rambo/dmdt-865_expansion/android/T865PortProbe/analysis/pins9-11-lora-cycle-2026-11-07/README.md

# pins9-11-lora-cycle-2026-11-07 capture notes

See [PINS9-11-LORA-CYCLE-2026-11-07.md](../PINS9-11-LORA-CYCLE-2026-11-07.md) for setup, results and limitations.
run_cycle.py performs a real DMD LoRa UI cycle; it is not a dry-run test.
Mapping CH1->10 CH2->9 CH3->3 CH4->11, ground pin 1. CH3 contact unverified.
