rambo/dmdt-865_expansion/references/fcc/SOURCES.md

# FCC photo sources retrieved 2026-11-06

Unmodified manufacturer/lab-submitted FCC exhibits obtained through FCCID.io.
None is established as a teardown of the Topicon MOD-LORA-E220 assembly.
EByte: one page, bare 433 MHz E220-400T30S radio; not the advertised 850-930 MHz Topicon accessory.
MDT865: seven pages total, tablet boards; no identifiable complete MOD-LORA-E220 assembly found in these reviewed pages.
The original FCC download endpoint returned HTTP 403; mirror PDFs were rendered and visually reviewed.
The EByte mirror is 649523 bytes (its metadata page lists 649525); the hash below describes the actual retrieved file.

EByte-E220-400T30S-internal-4983216.pdf
https://fccid.io/2ALPHE220/Internal-Photos/Internal-Photos-4983216.pdf
SHA256 43314c6d11cfb36a85e58e730b1f34d73f2a3e027f5b84f49c595dc417bbab7f

Topicon-MDT865-internal-01-6401292.pdf
https://fccid.io/2AHAFMDT865/Internal-Photos/Internal-Photos-01-6401292.pdf
SHA256 05f91a671e476278785c18257021d6a596d394e336b628edc07daaa0d4611135

Topicon-MDT865-internal-02-6401295.pdf
https://fccid.io/2AHAFMDT865/Internal-Photos/Internal-Photos-02-6401295.pdf
SHA256 d5247d95b9333e15b3ec4a690ce241914ec09cd2e26f199c34677c270b64be69
