rambo/dmdt-865_expansion/android/T865PortProbe/analysis/EXPANSION-PIN-BASELINE-2026-11-07.md

# Expansion contact baseline - 2026-11-07, Europe/Helsinki

## USER NUMBERING: VIEWED FROM TABLET BACKSIDE

Pin numbers run left-to-right within each row, then top-to-bottom.
Top-left pin 1; top-right pin 2; bottom-left pin 11; bottom-right pin 12.
These are local investigation labels, not established OEM numbering.

| Row | Left | Right |
| --- | --- | --- |
| Top | 1 GND? | 2 CH3 |
| 2 | 3 CH2 | 4 CH1 |
| 3 | 5 CH4 | 6 unknown |
| 4 | 7 +3.3 V? | 8 unknown |
| 5 | 9 unknown | 10 unknown |
| Bottom | 11 unknown | 12 unknown |

## USER CLARIFICATION AFTER CAPTURE

Ground clips were connected to pin 1. The user measured pin 7 near 3.3 V
relative to pin 1 and to known cradle-connector power pads: two ground pads
and two 5 V pads. This corroborates pin 1 as the ground reference; readings are
user-reported, not an independent scope measurement of pin 7.
The user removed probes to enable USB debugging. Timing relative to the scope
queries/screen capture is uncertain. Therefore the channel readings below are
NOT A VALID CONNECTED-PIN BASELINE and cannot establish any pad's voltage or role.
The mapping above records intended wiring. Actual probe multiplier switches
remain unconfirmed; the scope configuration alone reports x10.

## SCOPE CONNECTION

RIGOL TECHNOLOGIES,DS1074Z,DS1ZA162953663,00.04.05.SP2

Address 192.168.220.72, raw SCPI TCP port 5555 (5025 refused).
VXI-11/RPC port 111 and HTTP port 80 were reachable; raw SCPI was used.
HTTP welcome page has inconsistent placeholder instrument fields; trust *IDN?
and the LXI identification endpoint rather than that HTML model/serial.
Acquisition was running AUTO; no trigger, acquisition, display or channel settings
were changed. Query-only measurement readout and a screen PNG were collected.
Time scale: 5 ms/div; sampling readout: 50 MSa/s; all channels enabled, DC
coupling, 1 V/div, scope probe multiplier x10, no inversion or bandwidth limit.

## SCOPE CHANNEL READOUT ONLY - PROBE CONNECTIONS NOT VERIFIED AT CAPTURE

Sequential live queries, not a simultaneous capture. Planned pin column records
intended wiring only; do not attribute these values to the physical pins.

| Pin | Channel | Average mV | Peak-to-peak mV |
| --- | --- | --- | --- |
| 2 | CH3 | -19.97 | 80.0 |
| 3 | CH2 | -25.22 | 120.0 |
| 4 | CH1 | 4.41 | 160.0 |
| 5 | CH4 | -34.62 | 240.0 |

All frequency queries returned the scope invalid/unavailable sentinel 9.9E37;
CH1 minimum-voltage query also returned that sentinel. These are not voltages
or valid frequency values. The screen snapshot shows small common ripple rather
than obvious full-amplitude logic transitions. This baseline does not distinguish
ground, low outputs, disabled buses, unpowered interfaces, or floating inputs.
It does not exclude intermittent UART/I2C/SPI activity outside the snapshot.

## ADB BASELINE

ADB initially had no USB device; tablet subsequently appeared with transport_id 4.
T865 / mdt865, firmware mdt865_14_ngms_2.8.6, SELinux Enforcing, shell UID 2000.
DMD2 launcher and port probe v1.1 were present as running processes. No dmdLora
or freeme.factory process was shown by the targeted process query.
/dev/expand remains 0666 gpio_ctrl_device; WK1-3 remain 0666 user_tty_device.
No Activity was started and no screen interaction or settings changes were made.

## STATUS / NEXT STEP

User intends to install an available system update before continuing. Hardware
probing is paused at the user's request. The assistant did not initiate an update.
After the user resumes, re-read firmware fingerprint/kernel/config/permissions;
the recorded mdt865_14_ngms_2.8.6 and kernel investigation describe pre-update
software. Confirm probes are reconnected with the intended mapping and physical
attenuation settings, then capture a fresh baseline before any active experiment.
No expansion-device open, ioctl, EEPROM action, serial configuration, UART write,
power toggle, reboot or app installation was performed for this baseline.

## EVIDENCE

analysis/scope-2026-11-07/baseline-2026-11-07.json (timestamped SCPI queries)
analysis/scope-2026-11-07/baseline-2026-11-07.png (scope screen)
analysis/scope-2026-11-07/screen-query.json (screen-query provenance)
analysis/scope-2026-11-07/adb-baseline-2026-11-07.txt (tablet metadata)

SCPI command reference: RIGOL DS1000Z Programming Guide, :MEASure:ITEM?.
https://www.rigol.com/intl/products/oscilloscope/DS1000Z.html
