rambo/dmdt-865_expansion/android/T865PortProbe/analysis/REMAPPED-LORA-CYCLE-2026-11-07.md

# T865 remapped LoRa cycle — 2026-11-07 11:47 EET (09:47 UTC)

## RESULT

One requested enable cycle completed; original LoRa OFF, display keep-awake=0,
and original scope setup were restored and verified. The service is stopped.
Pin 7 stayed approximately 3.3 V. No full logic-level UART-like transitions were
captured on these channels. The earlier pin-3 pulse did NOT appear on new CH3.
The user subsequently reports CH3 may have become misaligned. Treat this cycle's
CH3/pin-3 result as unreliable for pad behavior; it does not overturn the earlier
708 ms pulse measured with CH2. Check CH3 tip/contact/location before another
experiment. No additional enable cycle was run after this capture.

## SETUP

Ground: pin 1. Backside rowwise numbering: (1,2),(3,4),(5,6),(7,8),(9,10),(11,12).
CH1 -> pin 6; CH2 -> pin 7; CH3 -> pin 3; CH4 -> pin 8.
All scope channels DC, 1 V/div, scope probe factor 10x. Physical probe switches
and tip contacts were not independently verified. Rigol DS1074Z, SCPI TCP 5555
at 192.168.220.72. Current firmware: mdt865_16_ngms_1.2.7, kernel 6.6.102.
The user's fluctuating measurement was pin 7 referenced to pin 8, never pin 3.
Pin 7 reads around 3.3 V referenced to pin 1. Pin 8 is NOT confirmed ground.

## CAPTURE VALIDITY

Scope armed in SINGLE, waited for WAIT, then FORCE accepted with TD readback
before the ADB enable tap. 3,000,000 BYTE samples/channel, 4 us/sample, covering
-1.2 to +10.799996 s relative to trigger. Trigger TD confirmed at 09:47:11.475 UTC;
enable tap began at 09:47:11.477, completed at 09:47:11.605. Scope STOP confirmed
at 09:47:22.442. The automatic ~0.7 s initialization attempt is inside the record.
Original and restored switch XML read OFF; enabled UI read ON, but the view can
lag the service's automatic preference update. Scope screenshot, raw waveforms,
preambles, command transcripts and host UTC events are preserved alongside this
report. Host and device wall clocks were not independently synchronized.

## MEASURED VOLTAGES (from raw samples and each channel's own preamble)

| Channel / stated pad | Minimum V | Median V | Maximum V |
| --- | --- | --- | --- |
| CH1 / pin 6 | 0.144 | 0.240 | 0.336 |
| CH2 / pin 7 | 3.150 | 3.294 | 3.437 |
| CH3 / pin 3 | 0.000 | 0.000 | 0.000 CONTACT SUSPECT |
| CH4 / pin 8 | -0.144 | -0.048 | 0.048 |

BYTE quantization is about 48 mV/count; these are approximate voltage readings,
not precision rail measurements. CH3 data is one constant ADC code throughout.
Small offsets/noise do not establish a pin's function or prove a ground.
No captured channel spans even 0.3 V; no normal 3.3 V UART pattern is visible.
This does not locate TX/RX or exclude traffic on other pins, or missed contact.

## DEVICE LOG INTERPRETATION

The DMD service again successfully opens /dev/expand. Native setPower(2,true)
and writeIo(2,1,true) return 0. Driver reports right-position user=1 and GPIO566
set to 1 SUCCESS. WK2 opens at 9600/8N1, then SleepConfig fails after ~0.5 s,
consistent with no compatible module attached. The driver reports GPIO release
and power-off; on/off log timestamps differ by approximately 692 ms.
These logs confirm software requests and return values; they do NOT verify the
voltage at a specific pad. Logical position 2 and GPIO566 are not physical pad IDs.

This attempt also reached DMD's fifth consecutive initialization failure with
no previous success. It logged 'Persistent disable' and set lora_enabled=false.
Static LoraService code confirms this threshold changes that saved preference;
it is not evidence of a new firmware block or irreversible device lockout.
Failure counters/preferences were not cleared. LoRa was originally OFF and ends
OFF. No radio module is attached; this session does not establish radio behavior.

## EVIDENCE / NEXT STEP

See remapped-lora-cycle-2026-11-07/ (SHA256SUMS.txt validates saved artifacts).
Earlier valid pulse: [POST-UPDATE-INVESTIGATION-2026-11-07.md](POST-UPDATE-INVESTIGATION-2026-11-07.md) and
post-update-2026-11-07/successful-cycle/. Its mapping was CH2 -> pin 3.
Do not confuse it with new CH2 -> pin 7. Retain that earlier pulse as stronger
pin-3 evidence pending probe-contact verification. Pin 7's constant voltage is
consistent with an always-present supply but does not identify the regulator or
prove its role. Pin 8's function and the UART contacts remain unconfirmed.
