rambo/dmdt-865_expansion/cad/fit-check/four-plates-preview.png

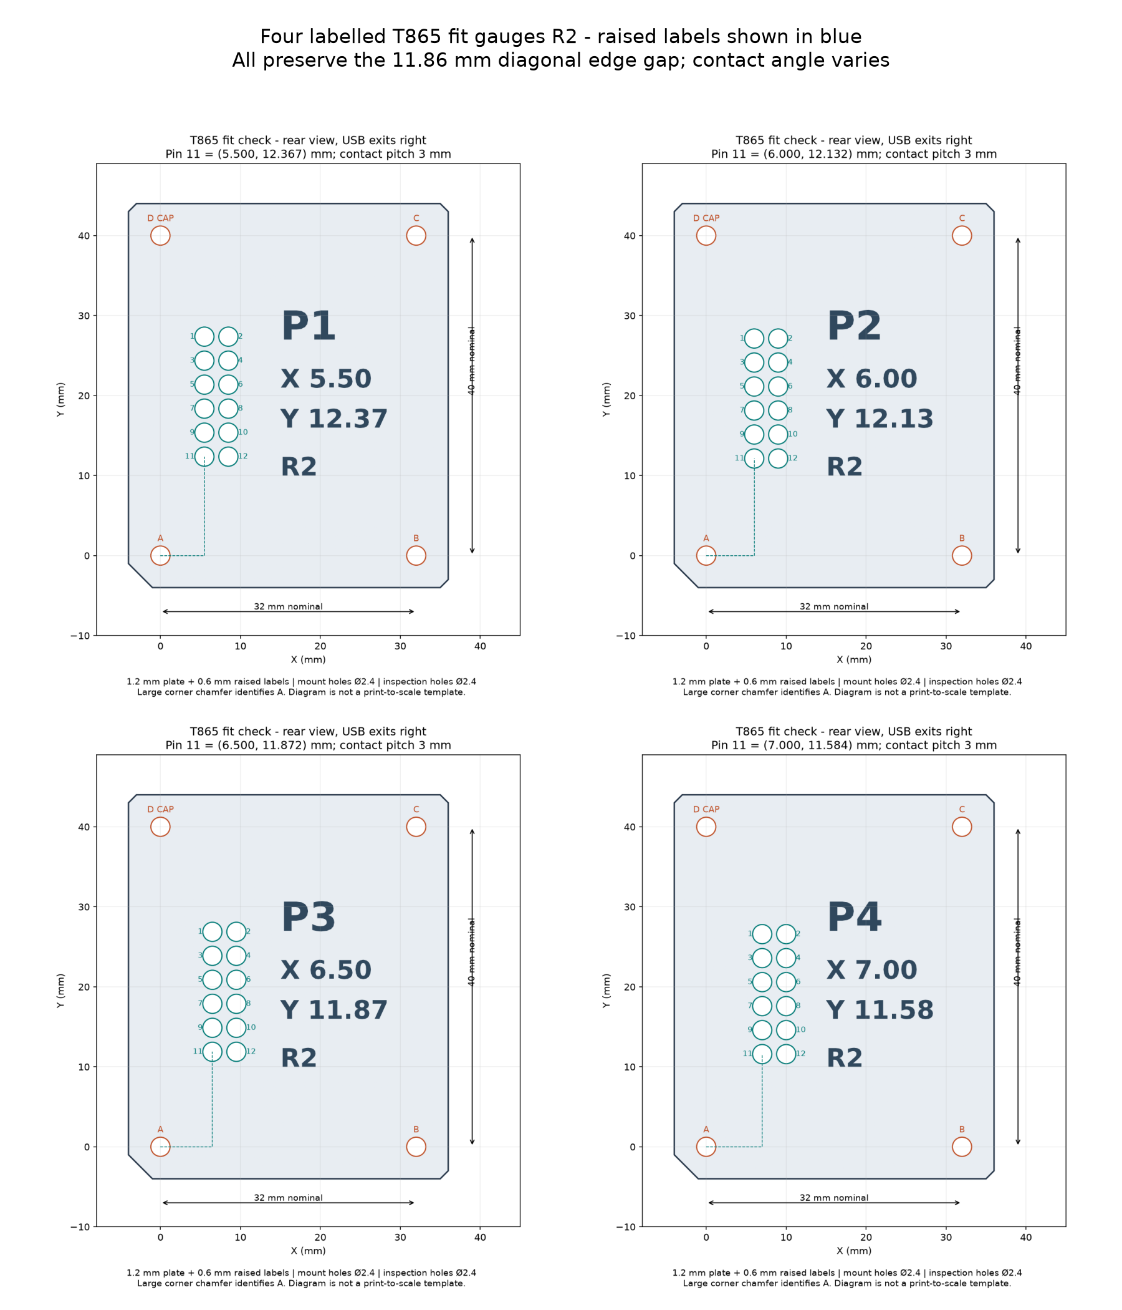
cad/fit-check/four-plates-preview.png
