rambo/dmdt-865_expansion/cad/fit-check/layout-P1.png

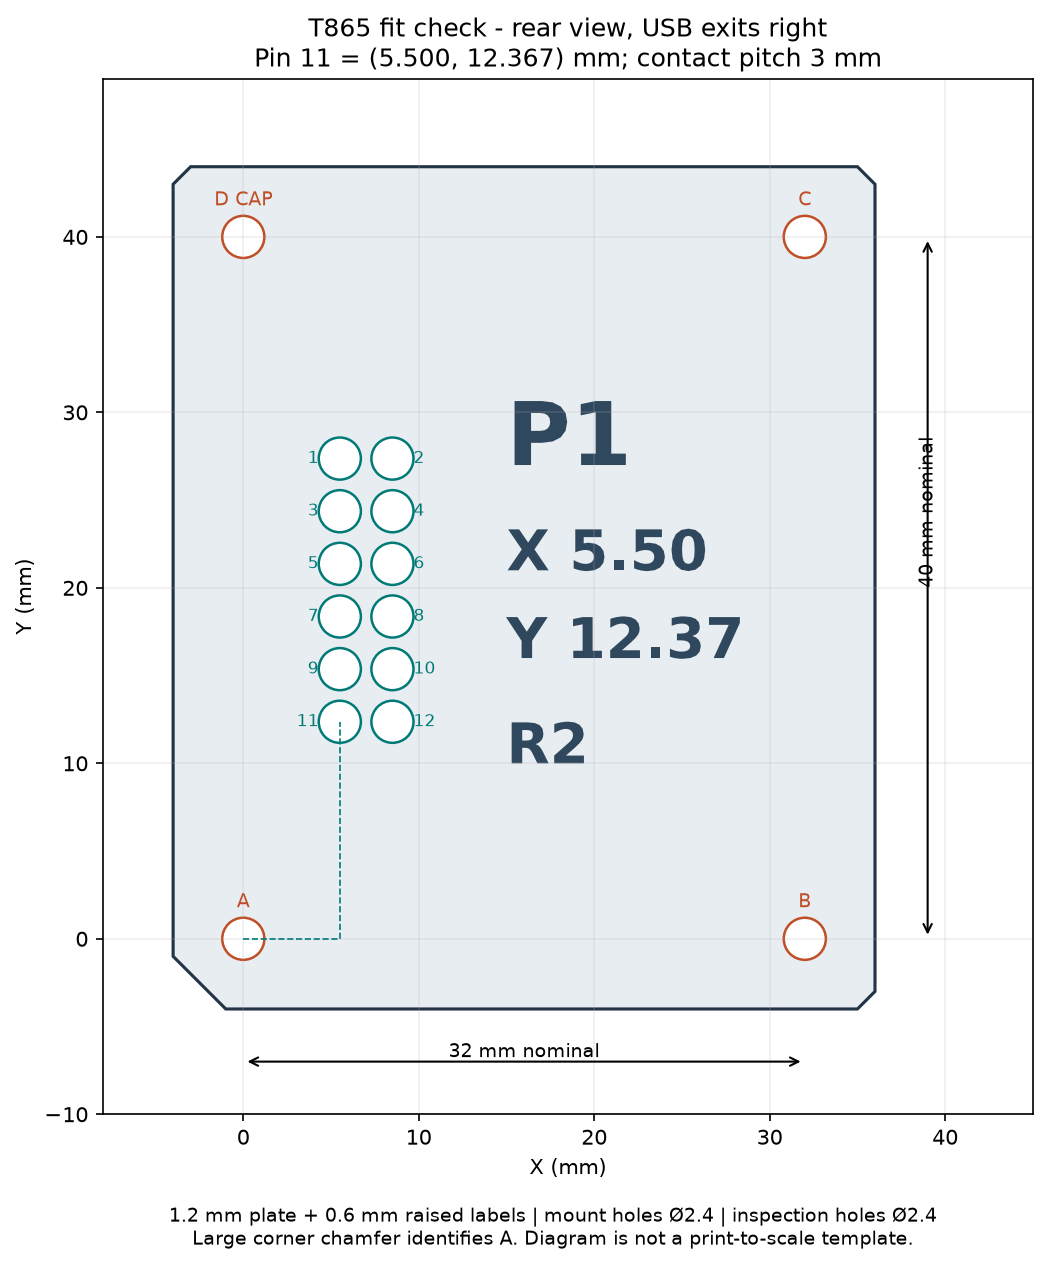
cad/fit-check/layout-P1.png
