rambo/dmdt-865_expansion/references/fcc/inspection/ebyte-photos-alt-overview.png

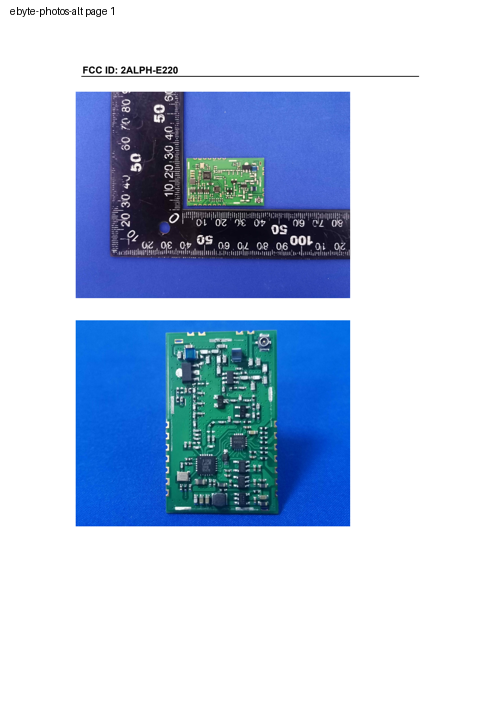
references/fcc/inspection/ebyte-photos-alt-overview.png
