rambo/dmdt-865_expansion/references/fcc/inspection/ebyte-photos-alt-p1-image0-Im1.jpg

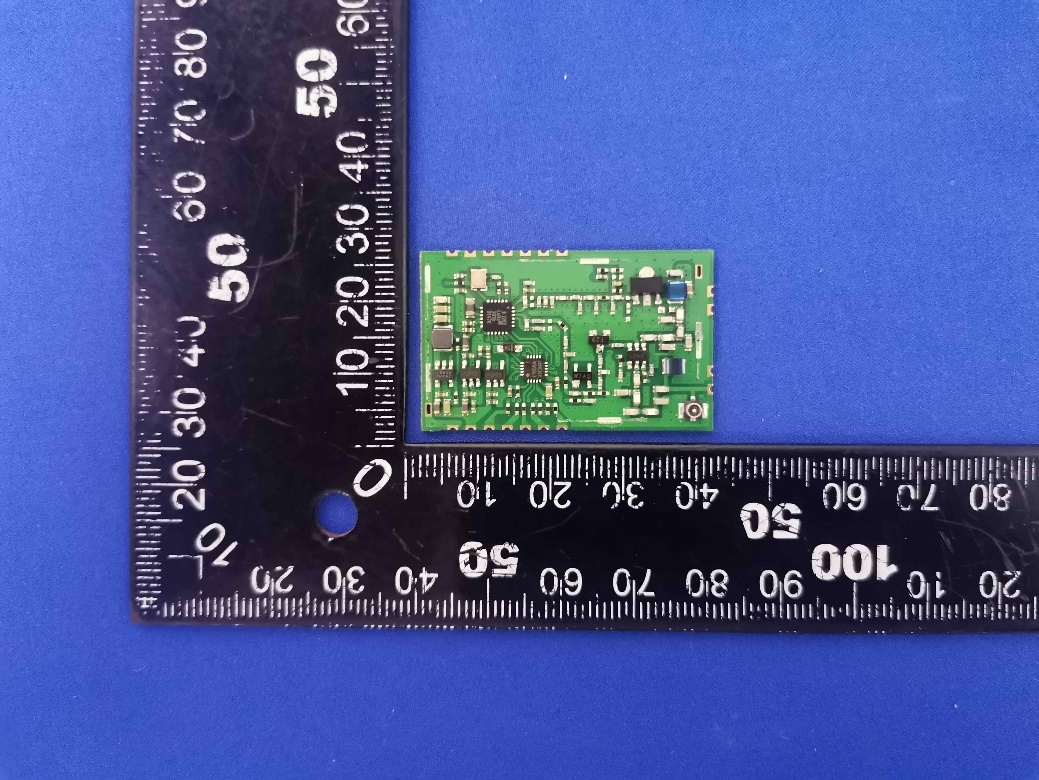
references/fcc/inspection/ebyte-photos-alt-p1-image0-Im1.jpg
