rambo/dmdt-865_expansion/references/fcc/inspection/ebyte-photos-alt-p1-image1-Im2.jpg

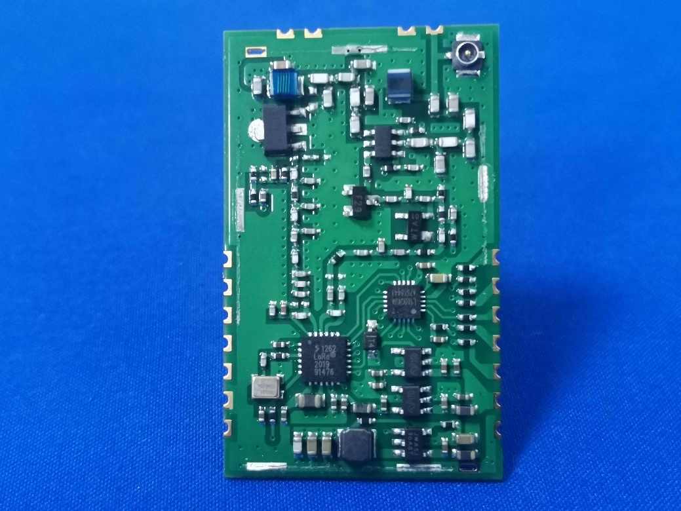
references/fcc/inspection/ebyte-photos-alt-p1-image1-Im2.jpg
