rambo/dmdt-865_expansion/references/fcc/inspection/mdt865-internal01-p4-image0-IM65.jpg

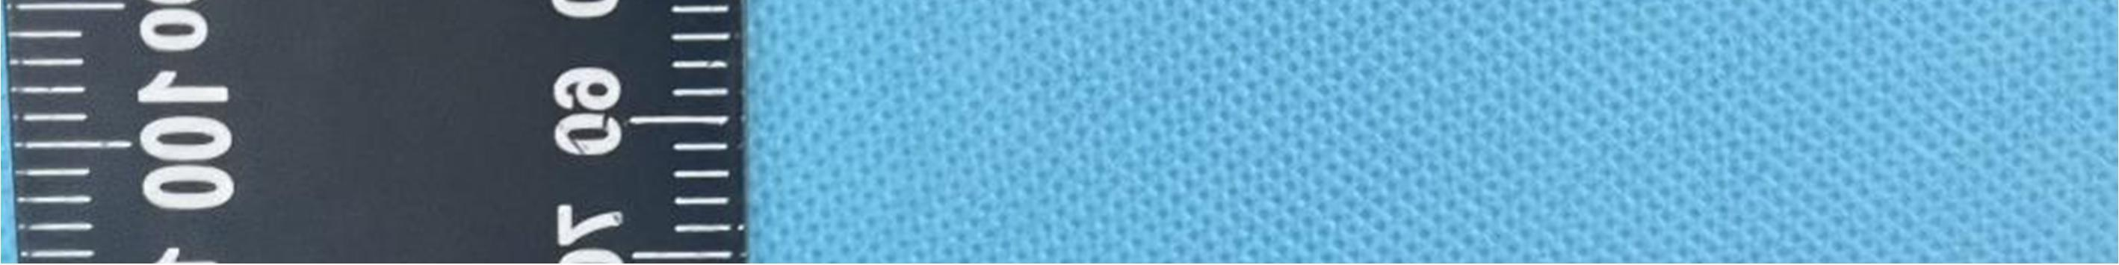
references/fcc/inspection/mdt865-internal01-p4-image0-IM65.jpg
