rambo/dmdt-865_expansion/references/fcc/inspection/mdt865-internal01-p4-image2-IM67.jpg

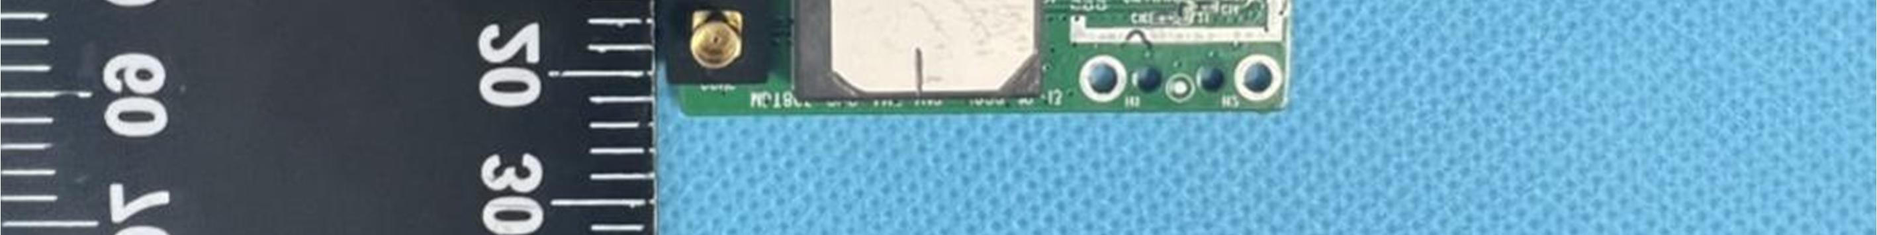
references/fcc/inspection/mdt865-internal01-p4-image2-IM67.jpg
