rambo/dmdt-865_expansion/references/fcc/inspection/mdt865-internal01-page5.png

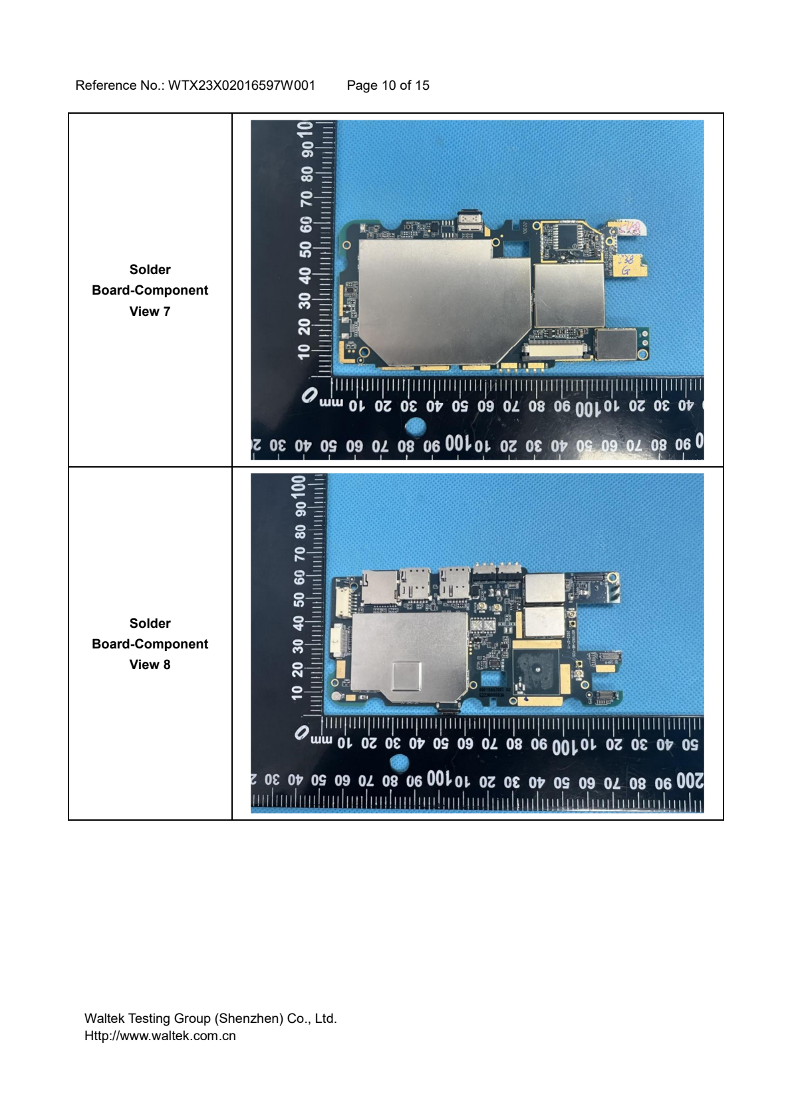
references/fcc/inspection/mdt865-internal01-page5.png
