rambo/dmdt-865_expansion/references/fcc/inspection/mdt865-internal02-overview.png

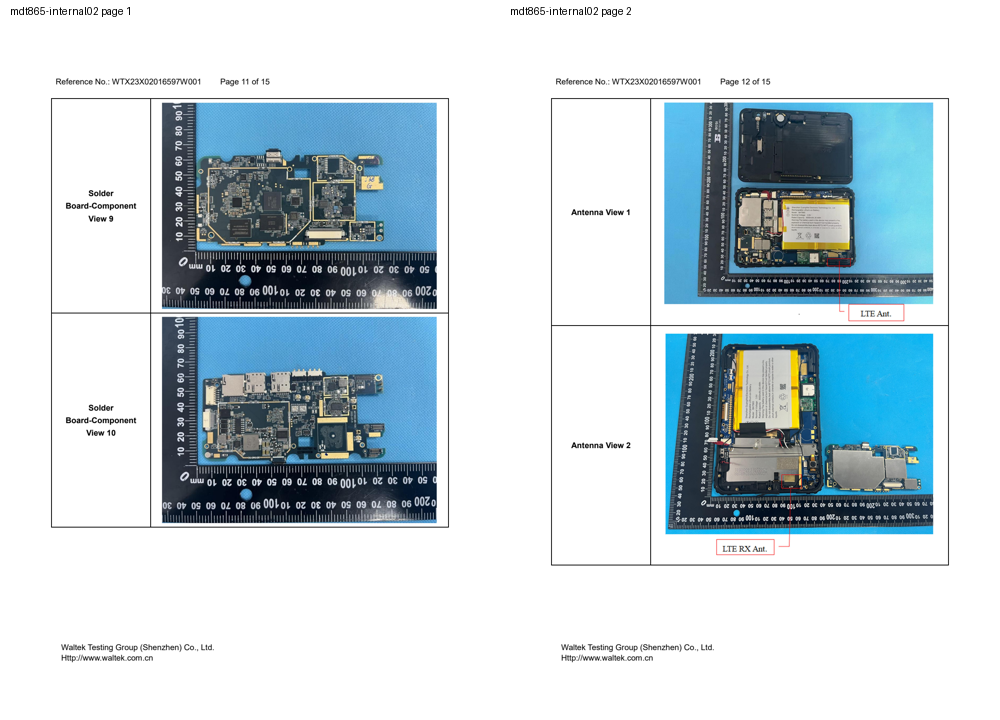
references/fcc/inspection/mdt865-internal02-overview.png
