rambo/dmdt-865_expansion/cad/fpc-retainer/T865-FPC-reference-assembly.step

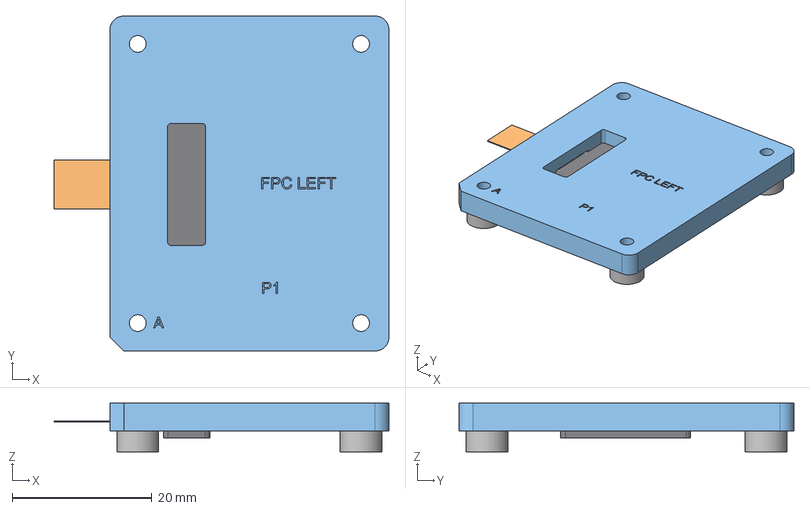
[picture p23: CAD file, 2026-11-13]
cad/fpc-retainer/T865-FPC-reference-assembly.step
48.0 x 48.0 x 7.00 mm
PRINTED_retainer
REFERENCE_connector_not_for_print
REFERENCE_left_FPC_not_for_print
REFERENCE_spacer_stack_0
REFERENCE_spacer_stack_1
REFERENCE_spacer_stack_2
REFERENCE_spacer_stack_3
