rambo/dmdt-865_expansion/cad/fpc-retainer/T865-FPC-retainer-assembly-coordinates.step

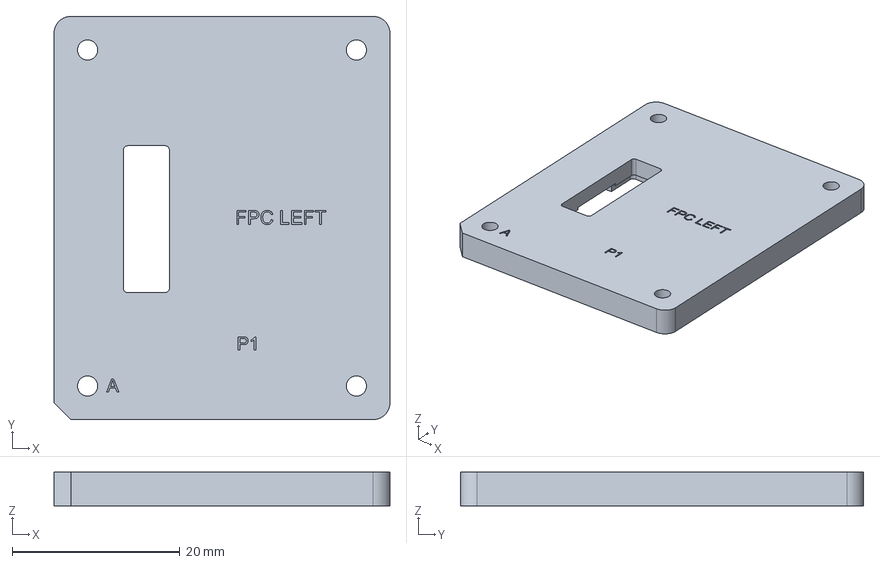
[picture p24: CAD file, 2026-11-13]
cad/fpc-retainer/T865-FPC-retainer-assembly-coordinates.step
40.0 x 48.0 x 4.00 mm
