rambo/dmdt-865_expansion/cad/fit-check/T865-P1.stl

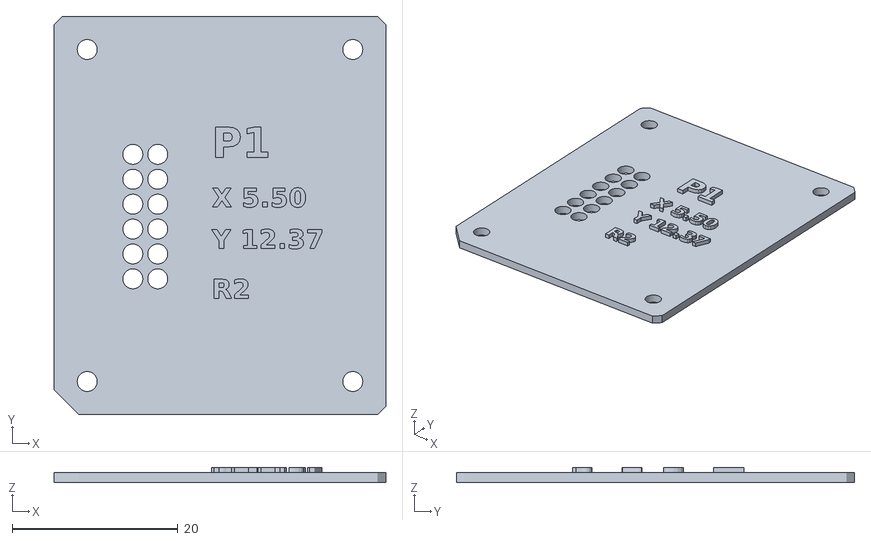
[picture p25: CAD file, 2026-11-07]
cad/fit-check/T865-P1.stl
40.0 x 48.0 x 1.80
