rambo/dmdt-865_expansion/cad/fpc-retainer/spacer-2.60mm.step

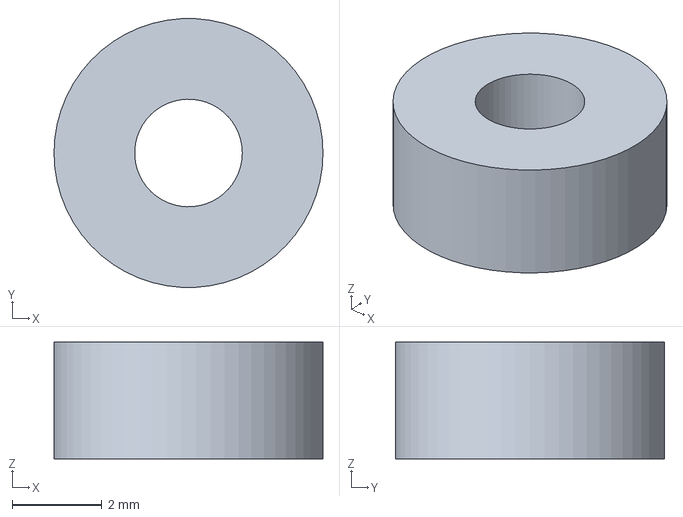
[picture p26: CAD file, 2026-11-13]
cad/fpc-retainer/spacer-2.60mm.step
6.00 x 5.99 x 2.60 mm
