rambo/dmdt-865_expansion/cad/fpc-retainer/T865-FPC-spacer-kit.stl

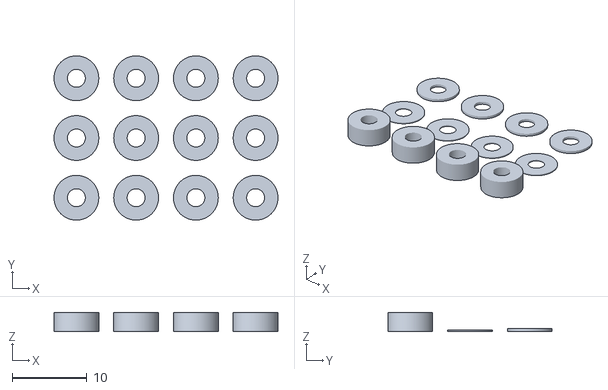
[picture p27: CAD file, 2026-11-13]
cad/fpc-retainer/T865-FPC-spacer-kit.stl
30.0 x 22.0 x 2.60
