rambo/dmdt-865_expansion/cad/fpc-retainer/T865-FPC-dimension-envelope.dxf

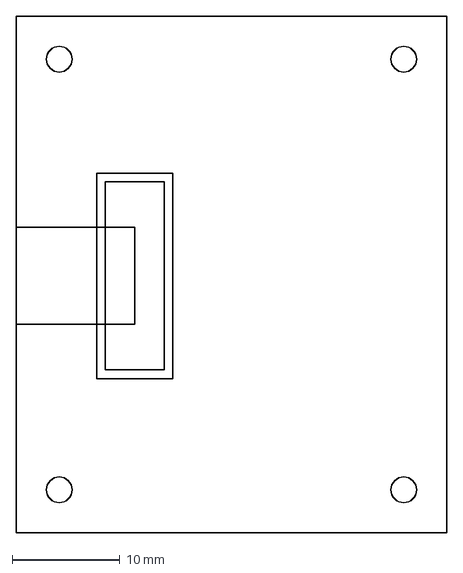
[picture p28: CAD file, 2026-11-13]
cad/fpc-retainer/T865-FPC-dimension-envelope.dxf
40.0 x 48.0 mm
