rambo/dmdt-865_expansion/cad/fpc-retainer/spacer-3.60mm.step

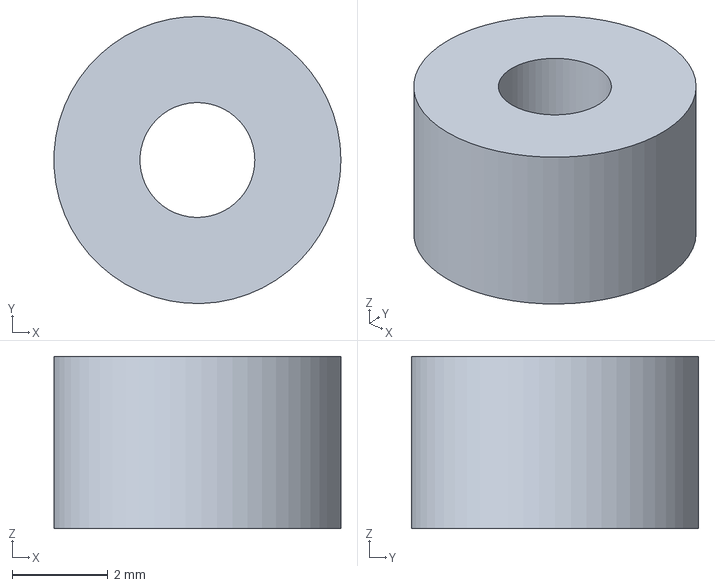
[picture p29: CAD file, 2026-11-13]
cad/fpc-retainer/spacer-3.60mm.step
6.00 x 6.00 x 3.60 mm
