rambo/dmdt-865_expansion/cad/fpc-retainer/spacer-0.40mm.step

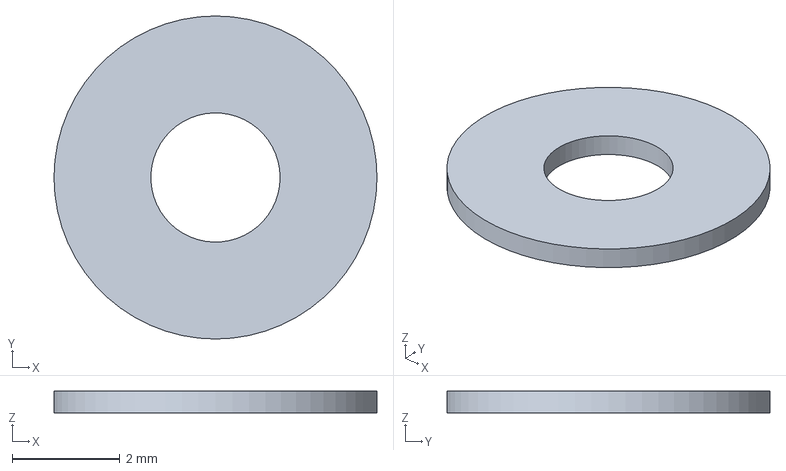
[picture p30: CAD file, 2026-11-13]
cad/fpc-retainer/spacer-0.40mm.step
6.00 x 6.00 x 0.4 mm
