rambo/dmdt-865_expansion/cad/fpc-retainer/spacer-0.20mm.step

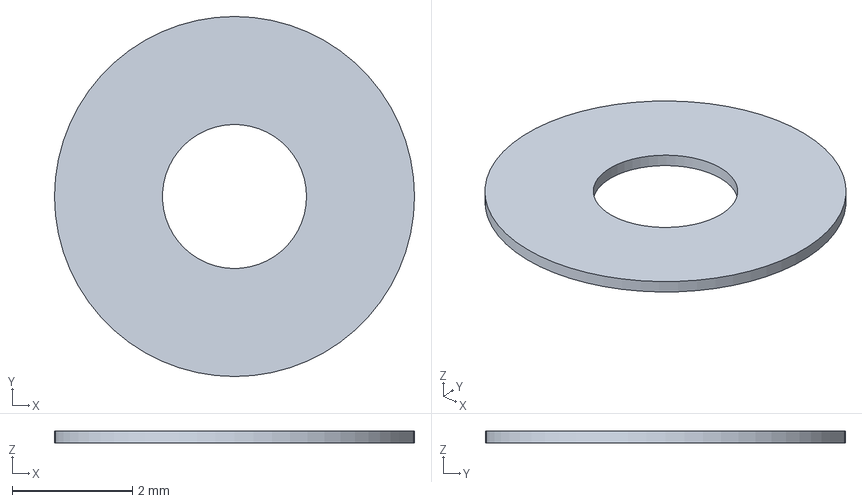
[picture p31: CAD file, 2026-11-13]
cad/fpc-retainer/spacer-0.20mm.step
6.00 x 6.00 x 0.2 mm
