rambo/dmdt-865_expansion/(list of files, cad)

Other CAD files:
cad/fit-check/T865-four-plates.stl
cad/fpc-retainer/T865-FPC-retainer-print.step
T865-four-plates.stl
T865-P2.stl
cad/fit-check/T865-P3.stl
T865-P1.stl
cad/fit-check/T865-P2.stl
T865-P3.stl
cad/fit-check/T865-P4.stl
cad/fit-check/T865-P1.dxf
cad/fit-check/T865-P2.dxf
cad/fit-check/T865-P3.dxf
cad/fit-check/T865-P4.dxf
cad/fit-check/T865-four-plates.dxf
cad/fpc-retainer/T865-FPC-retainer-assembly-coordinates.stl
cad/fpc-retainer/T865-FPC-retainer-print.stl
cad/fpc-retainer/spacer-0.20mm.stl
cad/fpc-retainer/spacer-0.40mm.stl
cad/fpc-retainer/spacer-2.60mm.stl
cad/fpc-retainer/spacer-3.60mm.stl
