rambo/dmdt-865_expansion/references/radio-manuals/inspection/page6.png

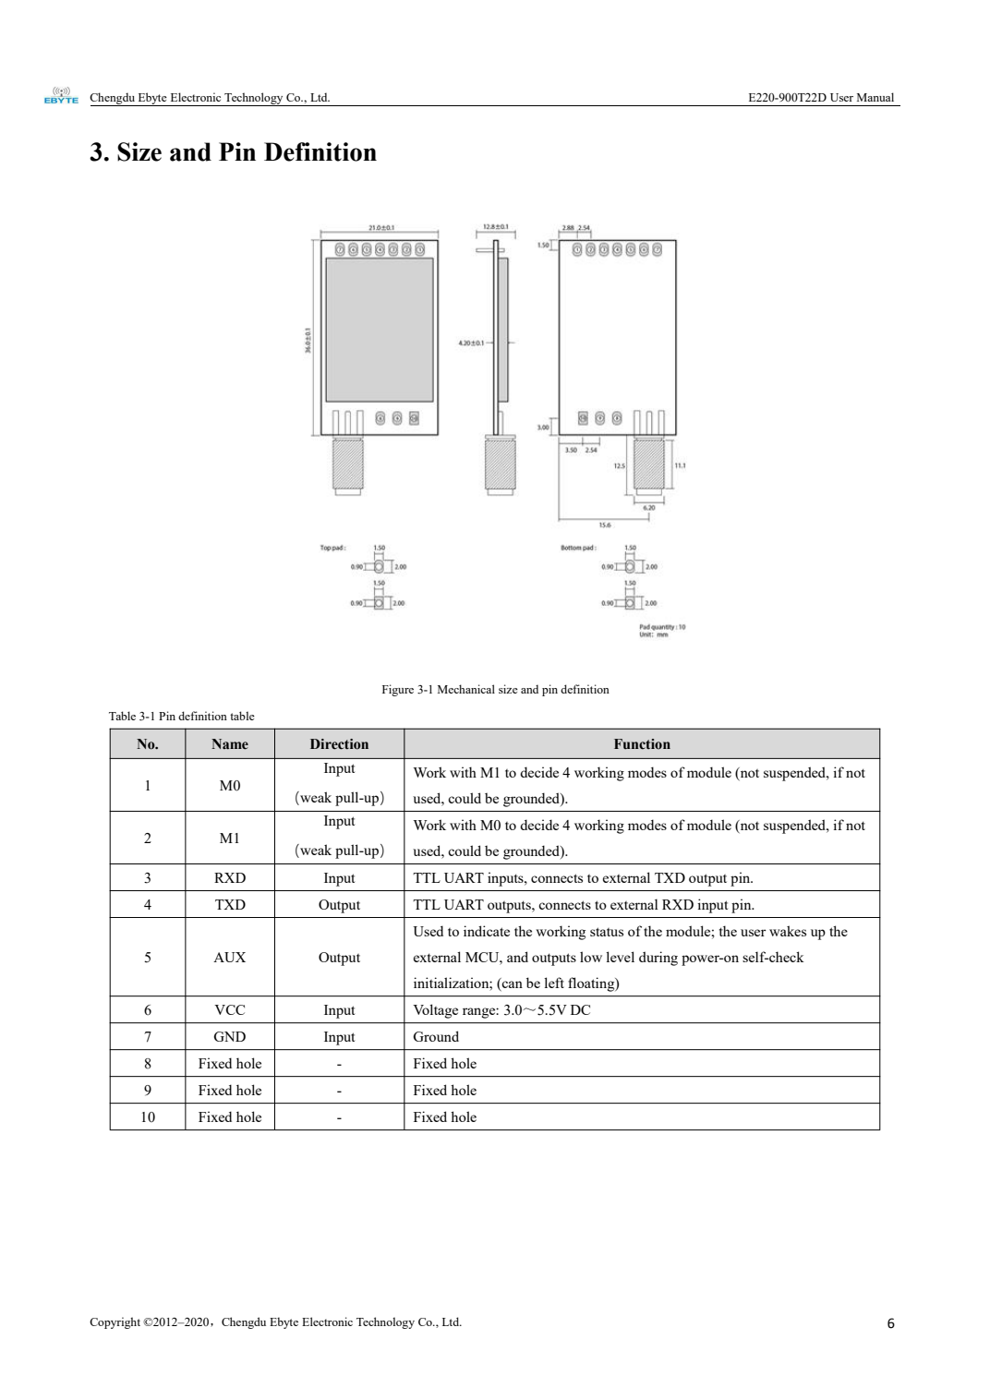
references/radio-manuals/inspection/page6.png
