rambo/dmdt-865_expansion/references/radio-manuals/inspection/page7.png

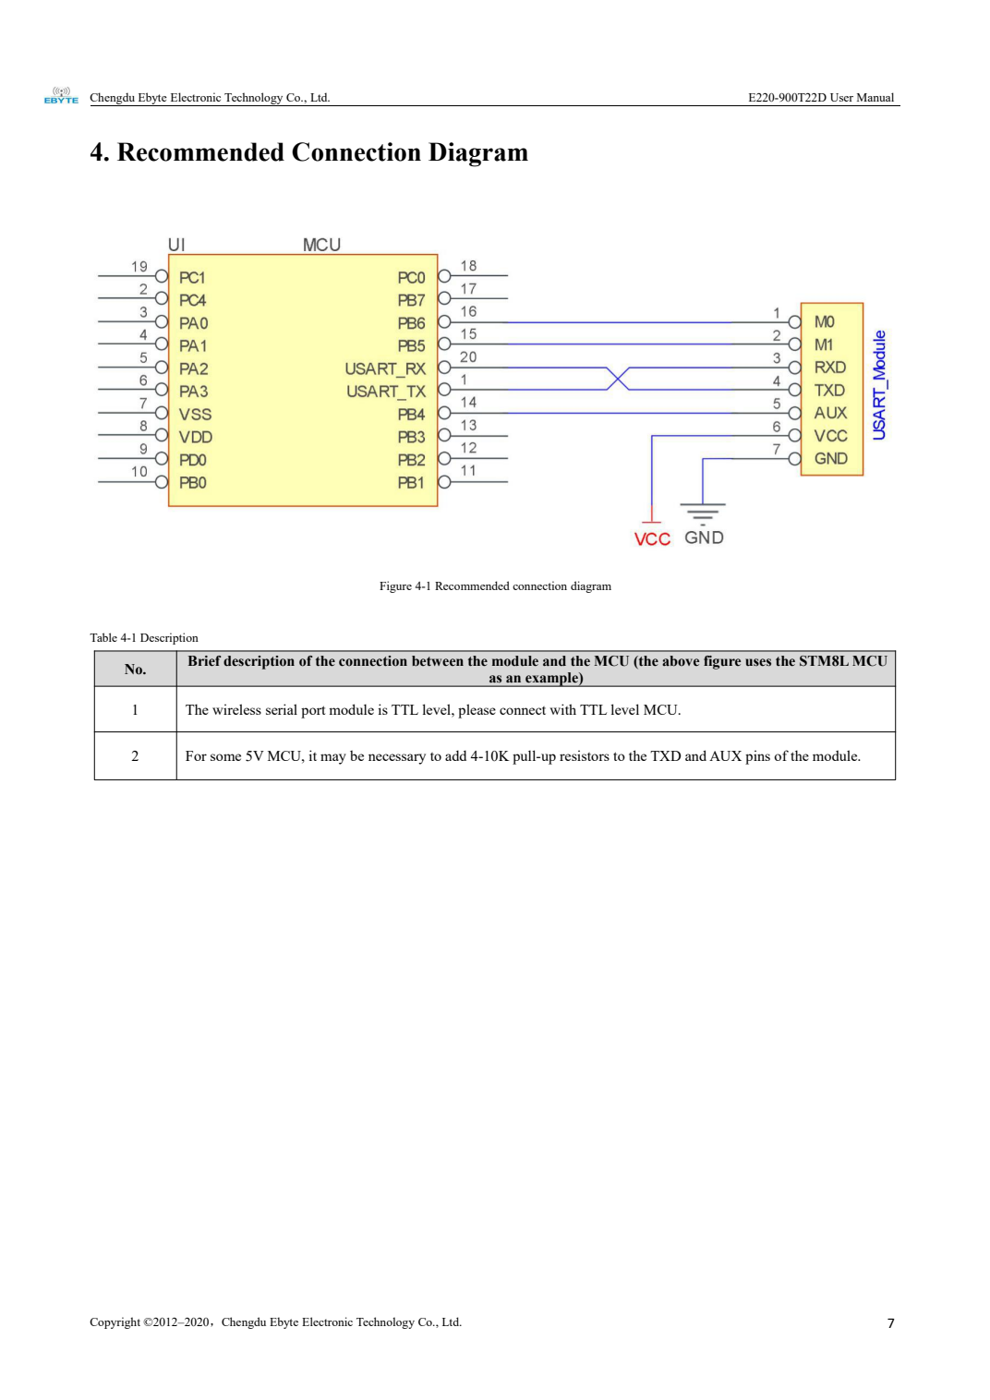
references/radio-manuals/inspection/page7.png
