rambo/dmdt-865_expansion/references/radio-manuals/inspection/page11.png

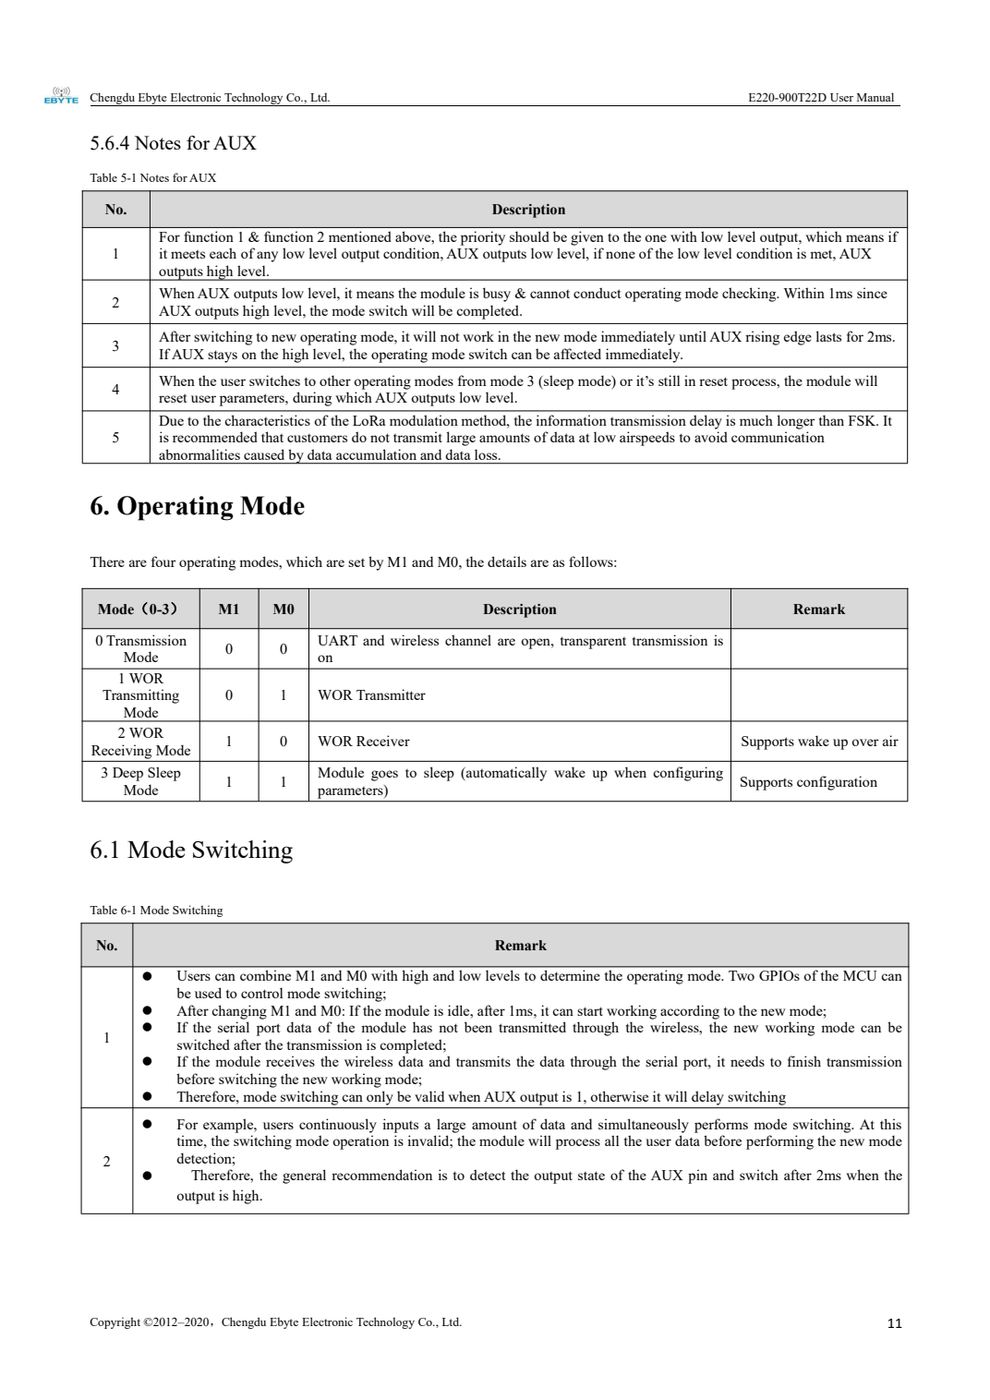
references/radio-manuals/inspection/page11.png
