rambo/dmdt-865_expansion/references/radio-manuals/inspection/page13.png

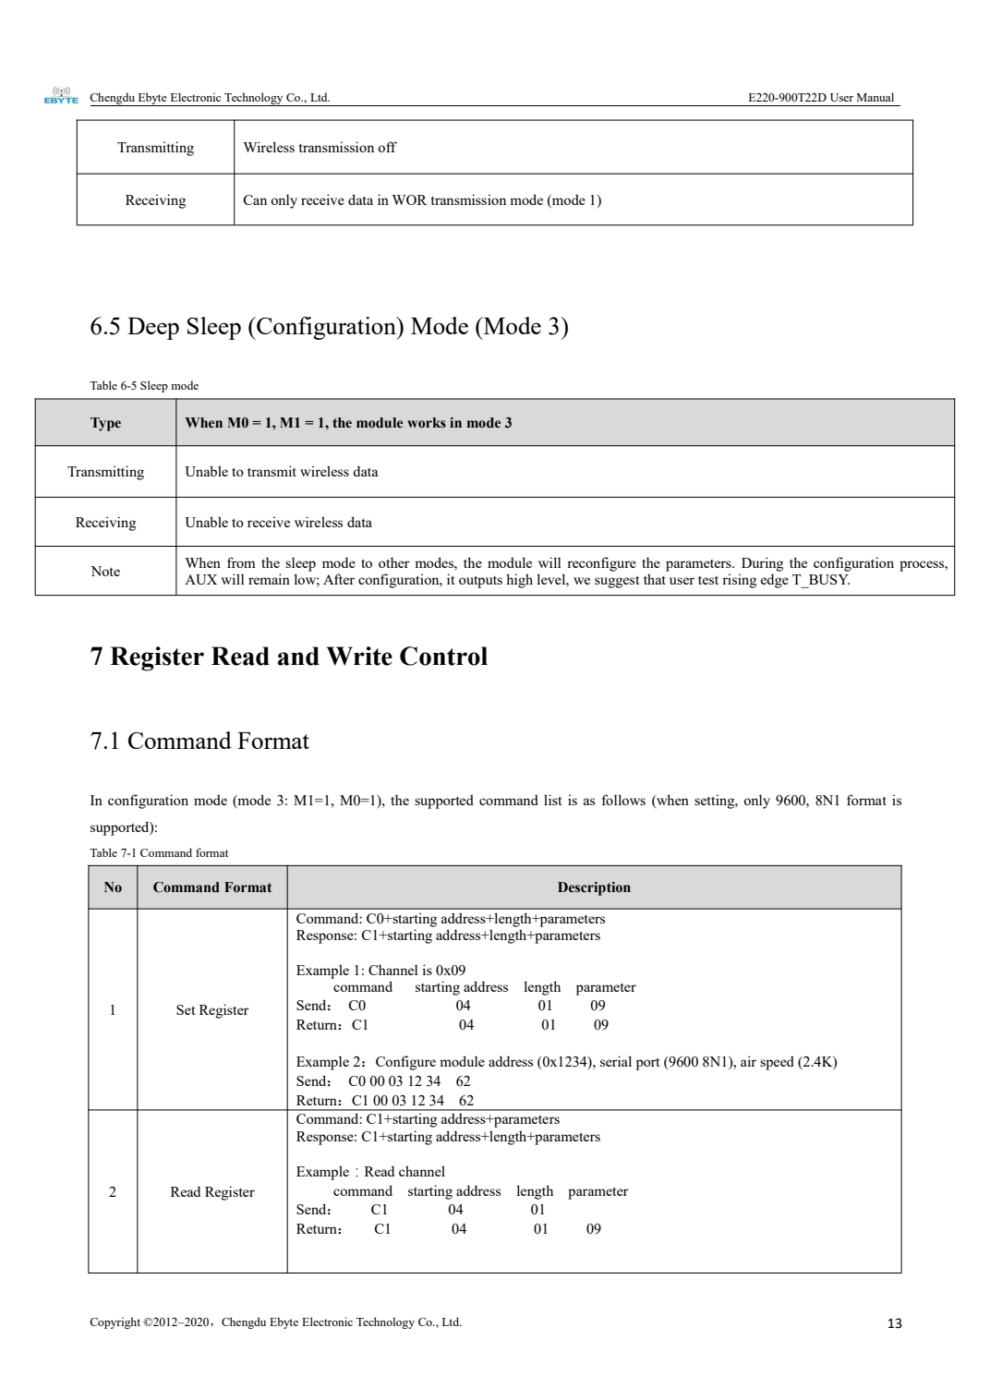
references/radio-manuals/inspection/page13.png
