rambo/dmdt-865_expansion/references/radio-manuals/inspection/page14.png

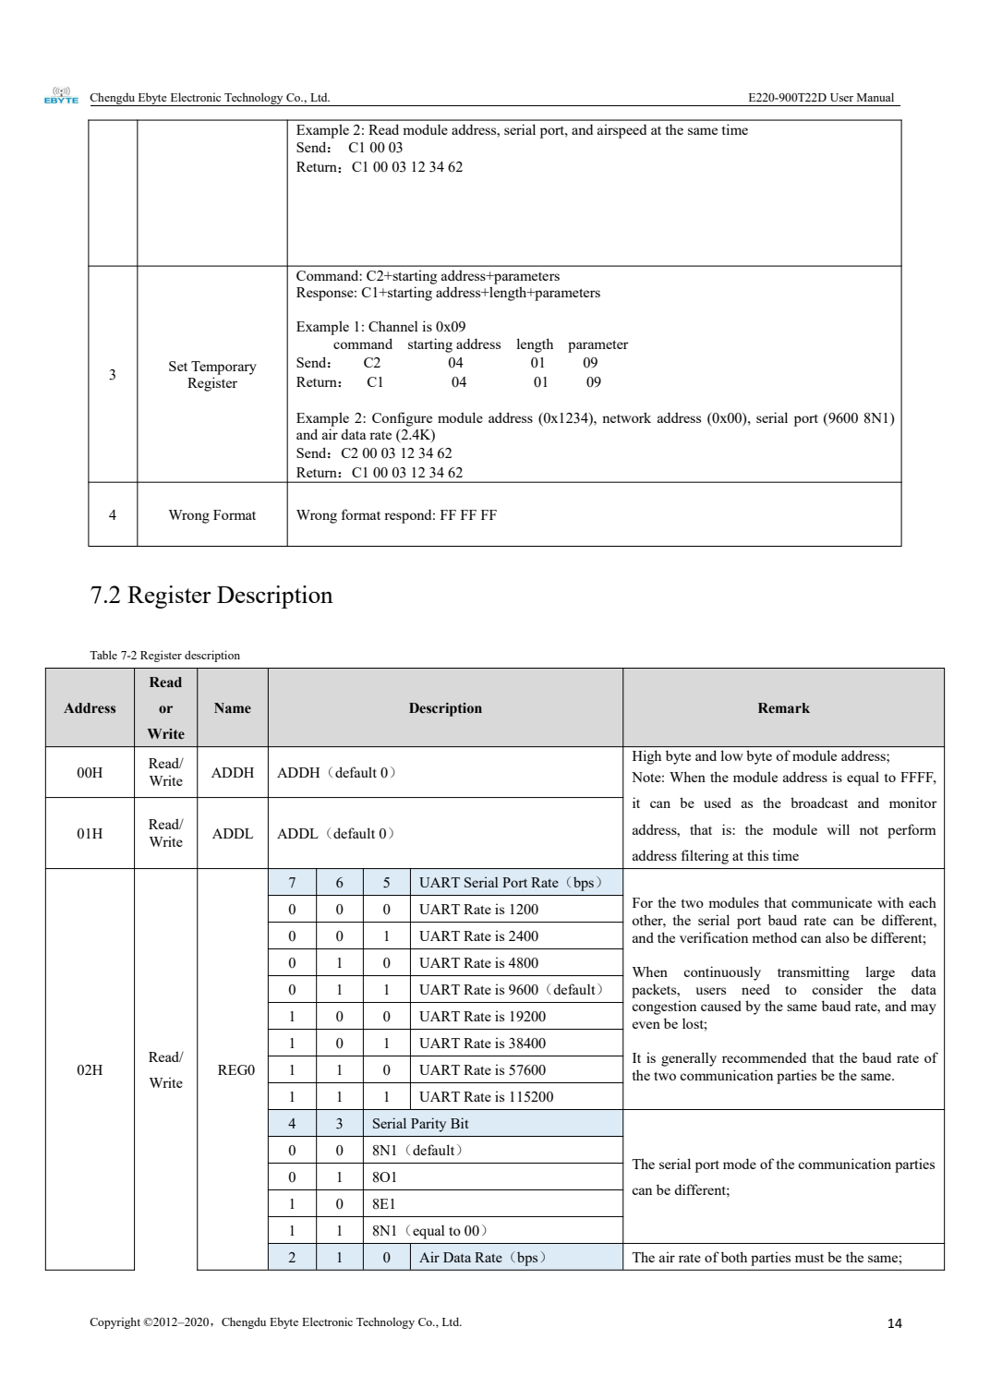
references/radio-manuals/inspection/page14.png
