rambo/dmdt-865_expansion/references/radio-manuals/inspection/page15.png

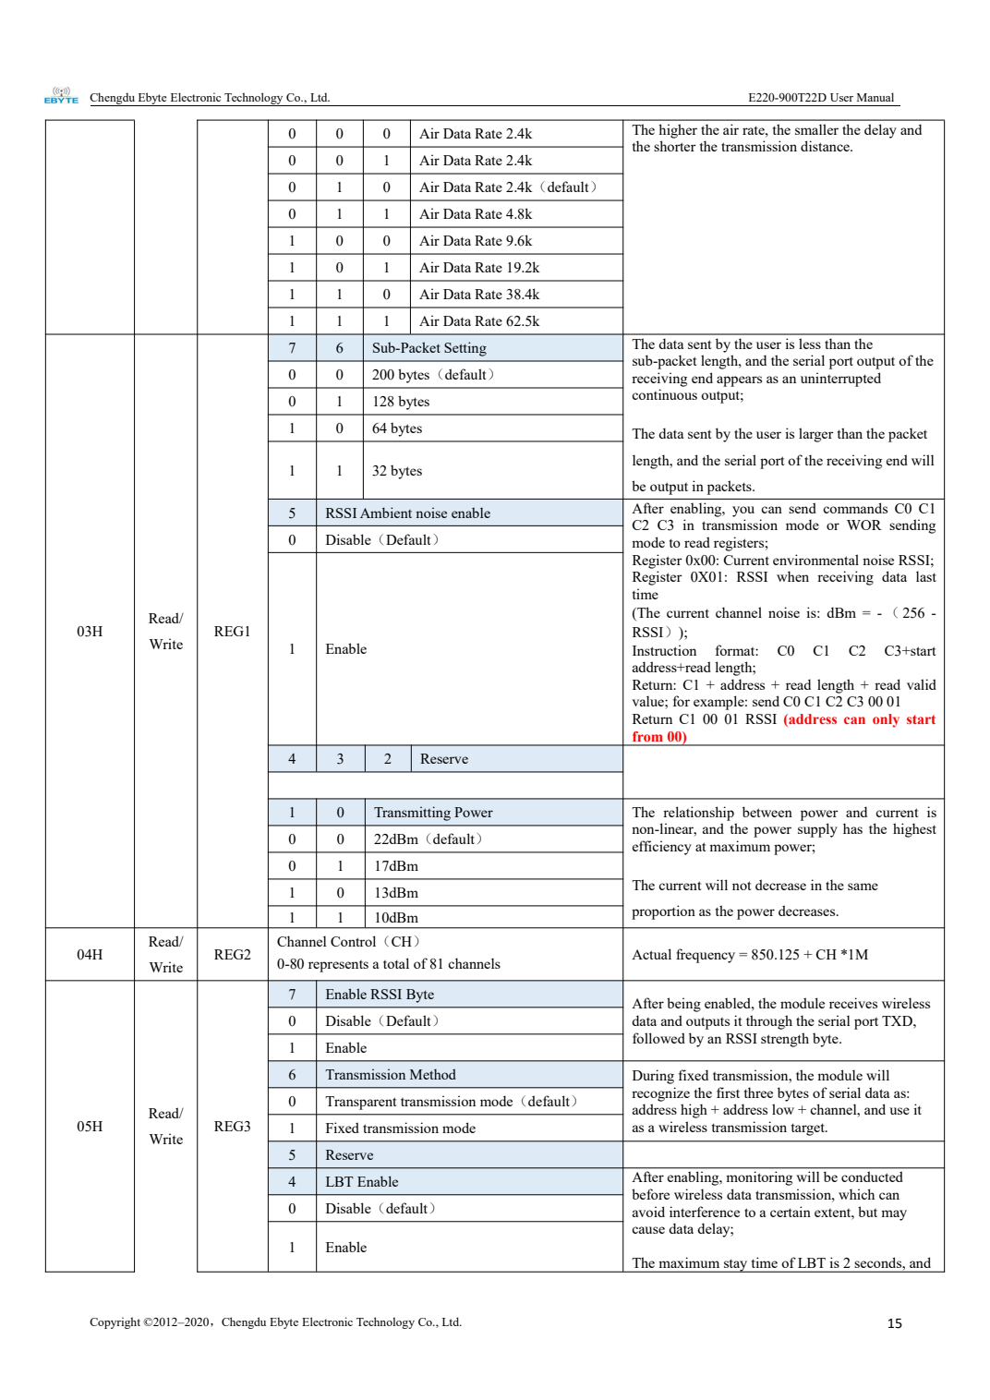
references/radio-manuals/inspection/page15.png
