rambo/dmdt-865_expansion/references/radio-manuals/inspection/page16.png

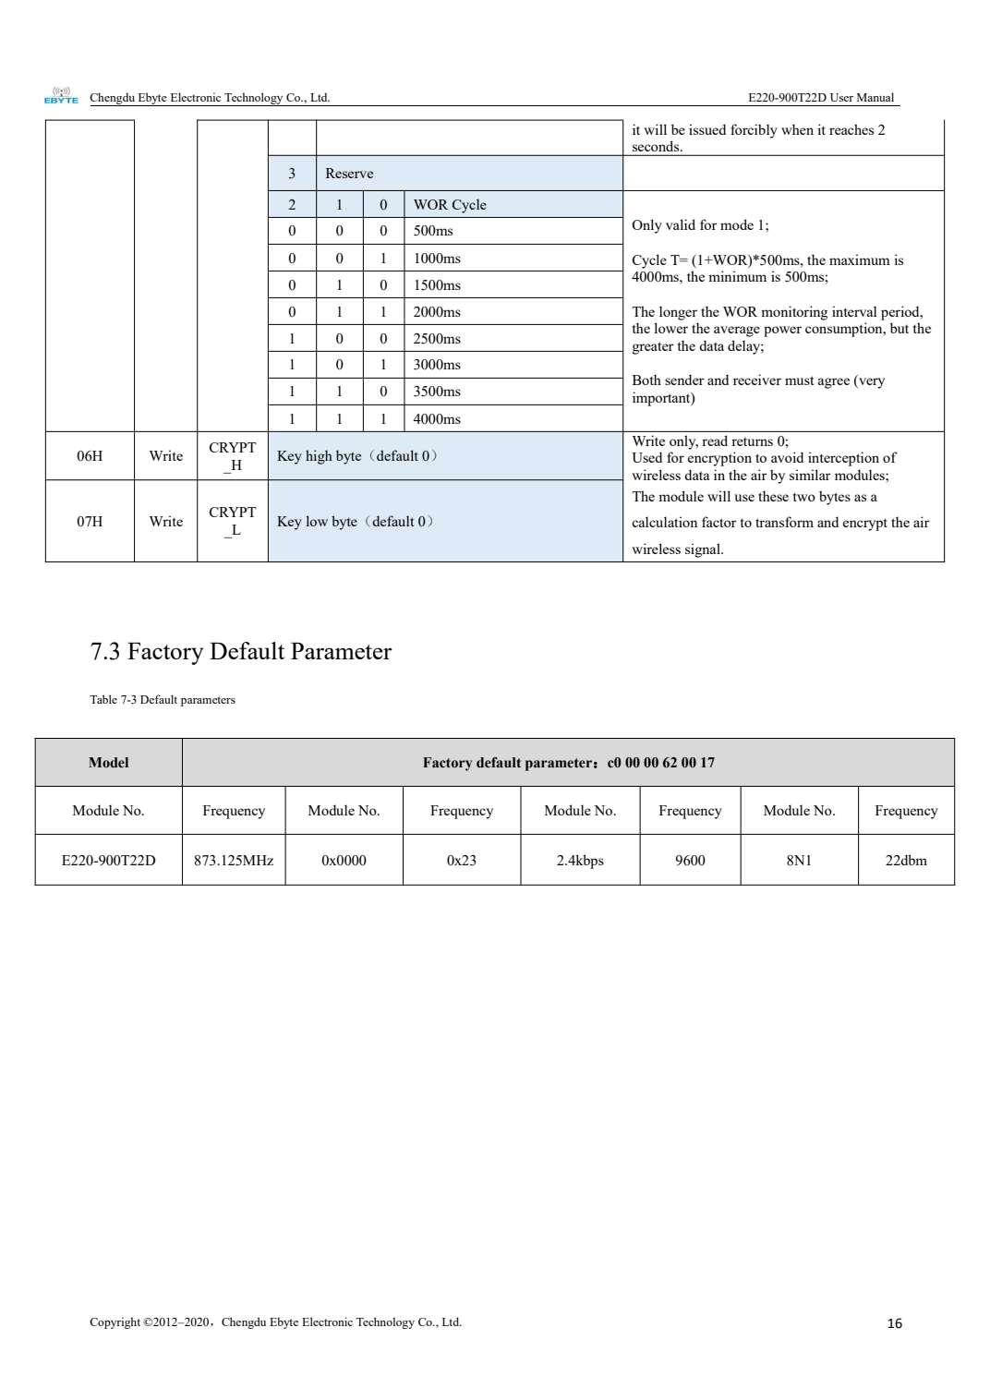
references/radio-manuals/inspection/page16.png
