rambo/dmdt-865_expansion/references/radio-manuals/inspection/relevant-pages.png

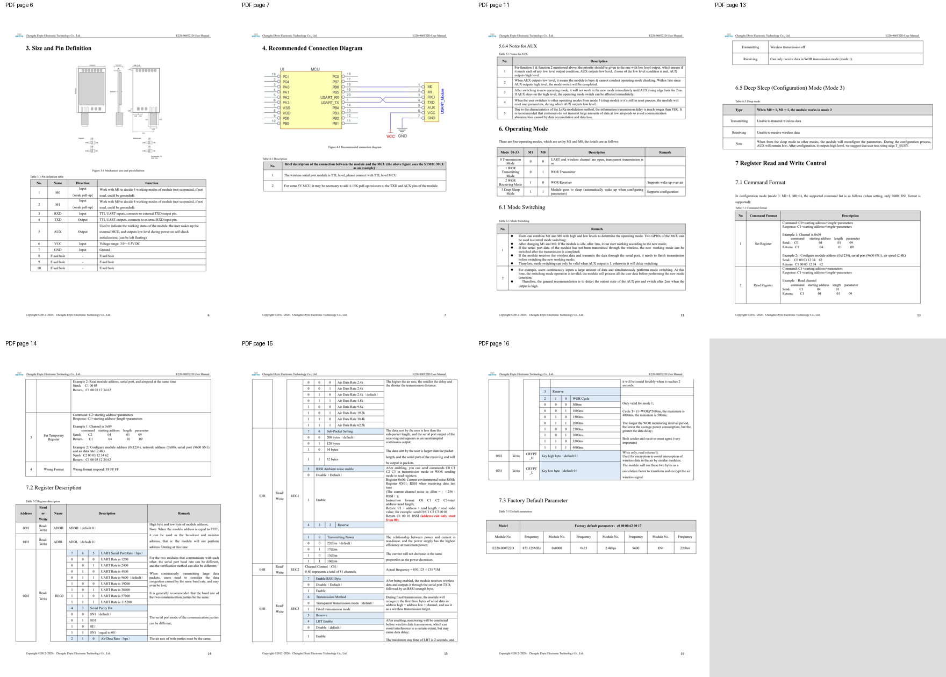
references/radio-manuals/inspection/relevant-pages.png
