rambo/dmdt-865_expansion/docs/measurements.md

# Current measurement index - 2026-11-13

This is the entry point for the electrical and mechanical measurements. Earlier
reports preserve the sequence of observations and corrections; use the latest
confirmed statements here when interpreting those historical records.

## Pin numbering and UART

Looking at the tablet back with the camera toward the top and USB exiting right:

| Left | Right |
| --- | --- |
| 1 | 2 |
| 3 | 4 |
| 5 | 6 |
| 7 | 8 |
| 9 | 10 |
| 11 | 12 |

Pin 1 is the user's ground reference. Pin 11 is /dev/ttysWK2 RX and pin 12 is
/dev/ttysWK2 TX, physically verified with exact payloads in both directions
using ESP32 GPIO26 TX and GPIO25 RX, at 9600/8N1. No new /dev/expand enable
command was used in that bench test; cold-boot behaviour without preceding DMD
enable cycles is untested. The radio module was not fitted.

The corrected [radio-board UART resistance readings](#radio-uart-to-connector-resistance-2026-11-13)
match these tablet assignments: radio RXD pin 3 connects to P12 and radio TXD
pin 4 connects to P11, each at approximately 22 Ω. The user corrected the
initial pogo-contact count; the apparent RX/TX pairing discrepancy is resolved.

| Pin | User's sequential multimeter reading relative to pin 1 |
| --- | --- |
| 2 | Initially about 2.5 V, falling; final level not established |
| 3 | 0 mV at that instant; separately observed to pulse high during LoRa enable |
| 4 | 1.79 V; later traced to R30 (<1 Ω to one end), candidate mode-control input |
| 5 | 1.5 V |
| 6 | 36 mV; later reported connected to R33, candidate mode-control input |
| 7 | 3.3 V; later traced to EEPROM SDA via ≈22 Ω |
| 8 | 1 mV; not established as ground |
| 9 | 3.3 V; later traced to EEPROM SCL via ≈22 Ω |
| 10 | 39 mV |
| 11 | 2.49 V; confirmed UART RX |
| 12 | About 2.5 V idle; confirmed UART TX |

Pin 12 also measured 2.464 V relative to a cradle ground pad. The measurements
were sequential, so that difference does not establish a fixed ground offset.
Low readings do not identify a ground pin, and measured high levels do not
establish input tolerance, output current capability or a usable supply.

See [pin map](reports/EXPANSION-PIN-MAP-2026-11-07.md),
[UART end-to-end test](reports/UART-END-TO-END-2026-11-07.md),
[probe wiring](reports/RX-PROBE-WIRING-2026-11-07.md),
[driver analysis](reports/EXPAND-DRIVER-ANALYSIS.md) and
[full handoff](reports/EXPANSION-PORT-HANDOFF.md).

The [GpioControl API trace](gpio-control-api.md) identifies logical I/O indices
used by the SDK/factory client. Position 2 / I/O 1 maps to kernel GPIO 566 in the
recorded log. Factory indices 2..5 are readback inputs in its test sequence;
their current-kernel validity, direction capabilities and contact mapping remain
unverified. Connector numbering, logical I/O indices and kernel GPIO numbers are
separate namespaces.

## Connector and mounting geometry

Contact openings are approximately 1.6 mm diameter. Measured outside spans
4.6 mm across two holes and 16.4 mm across six support a nominal **3 x 3 mm**
contact grid, with a 15 x 3 mm contact-centre rectangle.

Four mounting locations form a rectangle; the upper-left screw also retains
the cap of the round screw-in connector. The screw measured 1.94 mm outside
diameter, consistent with M2; the threaded opening measured about 1.75 mm.
Thread pitch and usable engagement depth were not measured.

The mounting spans **33.55 and 41.37 mm** were measured across the farthest
edges of the **threaded openings**, not the brass insert OD. Subtracting 1.75
gives 31.80 x 39.62 mm centres. The gauges test provisional nominal **32 x 40 mm**
spacing. It is not a verified OEM pattern; the long-axis difference is 0.38 mm.

The brass insert visible OD is **3.3 mm**, surrounded by a roughly 4 mm plastic
ring. The later 8.58 and 15.01 mm pin-11 spans referenced the brass OD and contact
opening, giving rough offsets 6.13 x 12.56 mm. These have substantially larger
error because there was no hard measurement stop.

A later shortest diagonal gap between the threaded-opening edge and pin-11
opening edge was **11.86 mm**, with further readings 11.75 and 12.00 mm and
approximately +/-0.1 mm error. This implies **13.535 mm centre distance** for
the working 11.86 value. It constrains a radius, not a unique contact angle.

The four [labelled fit gauges](../cad/fit-check/README.md) vary the pin-11
X offset from 5.5 to 7.0 mm and derive Y to preserve that diagonal. Original
[HEIC photos](../measurements/photos/originals/) and
[JPEG previews](../measurements/photos/previews/) document the measurements.

**Selected fit baseline: P1 R2**, based on the later physical comparison on
2026-11-07. User reports P1 alignment "just about perfect", P2 visibly misaligned,
and P3/P4 very badly aligned. The photographs show the same progression. Pin 11
is **(5.500, 12.367) mm** relative to lower-left mounting centre A; pin 12 is
**(8.500, 12.367) mm**, and pin 1 is **(5.500, 27.367) mm** in the model's rear-view
coordinate system. Keep the existing 32 x 40 mm mount pattern and 3 mm grid for
the selected prototype. The CAD values do not establish sub-millimetre accuracy:
2.4 mm inspection windows, seating and photograph perspective limit that claim.
Recess depth, working compression and an electrical pogo-pin contact fit remain
unmeasured. The other offsets are retained as rejected test variants.

See [reference index](../references/README.md) for individual pogo-pin candidates
and the earlier connector sourcing leads. No off-the-shelf 2x6/3 mm EU-stock
connector or final mechanical fit was established in that search.

## Evidence organization

First fit-check photos (IMG20261107175954 and IMG20261107180655): the user reports
slight top mounting-hole misalignment for P1 and good top-hole alignment for P2.
Their CAD mounting-hole coordinates are identical; printing, placement and seating
differences have not been isolated. The original contact inspection holes were too
small to judge alignment reliably. R2 enlarges those holes from 1.6 to 2.4 mm and
adds a raised revision label, while retaining all centres and offset variants.
This was the earlier first-print observation. The subsequent R2 comparison selects
P1: IMG20261107221537 (P1), IMG20261107221707 (P2), IMG20261107221817 (P3) and
IMG20261107221926 (P4). See the CAD README for the comparison table.

Original versioned captures are under
[the port-probe analysis directory](../android/T865PortProbe/analysis/).
[measurements/scope-workspace](../measurements/scope-workspace/) preserves the
additional capture workspace with its original relative paths. Some files are
duplicates of the versioned bundles; this preserves bundle/script references.

[evidence-manifest.json](evidence-manifest.json) records source groups, repository
paths, byte sizes and SHA-256 hashes for supplementary imported evidence. It does
not enumerate the application files already preserved in their Git histories.

## LoRa module teardown (2026-11-11)

[Disassembly analysis](reports/LORA-MODULE-TEARDOWN-2026-11-11.md) identifies
the shielded module as **EBYTE E220-900T30S** and U2 as an **AT24C02C** EEPROM.
The `ADRS / 883` power-stage IC is a high-confidence **MP2155GQ buck-boost**
match (manufacturer top mark `ADR`, ten-pad package, adjacent `3R3` inductor).
Its output voltage and enable wiring remain unmeasured. The EEPROM's `0x56`
board label likely denotes its I2C address; no contents were read.
[Original photos and previews](../measurements/photos/lora-teardown-2026-11-11/)
preserve the evidence. These photos do not yet establish a carrier schematic
or prove the absence of an MCU.

Follow-up close-ups identify U1 as a strong **LP3987H-33B5F (3.3 V LDO)**
match using the manufacturer's `LPS / 1eYWX` marking table. The paired `KN`
transistors are candidate **2SK3018-family MOSFETs**; exact manufacturer and
signal connections remain unverified. U1 has five pins, correcting the
initial impression from the wider photo.

## Contact relocation adapter (2026-11-11)

[Adapter photos and assessment](reports/EXPANSION-ADAPTER-2026-11-11.md) show
a passive-looking flex between two 2 x 6 contact arrays, with pogo contacts
at one end and flat lands at the other. User reports four mounting screws
at one end and two at the other. Flex text includes `MDT65-barometer-FPC`
and `JFHD-MDT865`; the presumed phone association is unconfirmed.
No contact mapping or mechanical dimensions have been derived from the photos.

Caliper photos now record the FPC pogo block's black body as **18.67 x 6.67 mm**
(length x width). Body height, pin protrusion/travel, corner radii and flex-exit
clearance remain unmeasured; printer fit allowance is separate from these dimensions.

The [unpowered radio PCB probing plan](reports/RADIO-PCB-PROBE-PLAN-2026-11-11.md)
prioritizes ground, supply paths, enables/mode pins, UART and EEPROM mapping
before the connector side becomes inaccessible. Pin 2 as switched supply
is a working hypothesis from the wider FPC trace and earlier voltage decay,
not a confirmed electrical assignment.

## Radio PCB resistance measurements (2026-11-13)

| From | To | Reported resistance |
| --- | --- | --- |
| P1 | U2 EEPROM pin 4 (GND) | 0.8 Ω |
| P1 | U.FL shield | 0.8 Ω |
| P1 | U1 pin 2 (GND) | <1 Ω |

These user readings support P1 sharing ground with U1, the EEPROM and the
antenna connector shield. Shorted-lead/contact resistance and reverse-probe
readings were not supplied; the values include lead/contact resistance.
The [probing worksheet](reports/RADIO-PCB-PROBE-PLAN-2026-11-11.md)
records all three readings and the photo-based U1 pin orientation.

### Connector-to-ground survey

User readings on the radio PCB in the ongoing unpowered session. The user
confirms **U2 pin 4 (GND)** was the accessible reference for the survey; pogo
contacts are probed one at a time because they are difficult to contact reliably.

| Contact | Resistance to U2 pin 4 (GND) |
| --- | --- |
| P2 | ≈500 Ω |
| P3 | Open |
| P4 | Open |
| P5 | <1 Ω in both probe directions |
| P6 | Open |
| P7 | ≈640 Ω |
| P8 | Open |
| P9 | ≈722 Ω |
| P10 | Open |
| P11 | ≈833 Ω |
| P12 | ≈833 Ω |

“Others open” supplies the P3/P4/P6/P10 entries. Reverse-probe readings for
contacts other than P5, settling behaviour and lead baseline remain unreported.
Open means the reported meter indication; finite readings include all in-circuit paths.

**P5 shares the radio PCB ground with strong continuity evidence:** below 1 Ω
to U2 pin 4 in both directions. Earlier unloaded tablet-side P5 measured 1.5 V
relative to P1. The user's proposed weak tablet-side pull-up could explain that
reading, but no loaded-voltage test or circuit trace has established it. The
board-ground measurement does not establish the tablet-side pin circuitry.
P11/P12 having equal readings does not establish continuity between them.

### P2 power-path trace

| From | To | Reported resistance |
| --- | --- | --- |
| P2 | U1 pin 1 (VIN) | <1 Ω |
| P2 | Candidate MP2155 pin 5 (VIN) | <1 Ω |
| P2 | Candidate MP2155 pin 6 (EN) | <1 Ω |
| P2 | U1 pin 3 (EN) | <1 Ω |
| P2 | U1 pin 5 (VOUT) | ≈570 Ω |
| P2 | U2 pin 8 (VCC) | Open |
| P2 | Radio pin 6 (VCC) | Open |

**P2 has a low-resistance connection to U1 VIN.** Applied voltage, upstream
switching and downstream supply routing remain unverified. Open readings from
P2 to load VCC pads do not rule out a power path through an enabled regulator.
The 570 Ω reading is an in-circuit value, not a proven discrete resistor.
Reverse-probe and settling results were not supplied.

The [exact module manual supplied by the user](../references/lora-teardown/E220-900T30S_UserManual_EN_v1.0.pdf)
resolves the radio pin numbering: this is the **18-pad layout**, with **pin 6
VCC**, pin 7 GND, pin 3 RXD, pin 4 TXD, pin 1 M0, pin 2 M1 and pin 5 AUX.
The older archived manual describes a different **24-pad layout** and must not
be used for this module's pin numbering. The worksheet now uses the correct manual.

### U1 output trace

| From | To | Reported resistance |
| --- | --- | --- |
| U1 pin 5 (VOUT) | U2 pin 8 (VCC) | <1 Ω |
| U1 pin 5 (VOUT) | Radio pin 6 (VCC) | ≈650 Ω |
| Candidate MP2155 pin 1 (VOUT) | Radio pin 6 (VCC) | <1 Ω |

The low-resistance connection establishes that U2 EEPROM VCC shares U1's output
net. U1's marking identifies the nominal 3.3 V LDO variant; no powered output
voltage has been measured. The 650 Ω in-circuit reading does not establish a
shared rail with radio VCC or a discrete 650 Ω resistor. Radio supply routing was subsequently traced to candidate MP2155 VOUT (below). Reverse-probe readings and settling behaviour were not reported.

### U1 input/output probe-polarity check (2026-11-13)

| Red probe | Black probe | Reported resistance |
| --- | --- | --- |
| U1 pin 5 (VOUT) | P2 (connected to U1 VIN) | ≈570 Ω |
| P2 (connected to U1 VIN) | U1 pin 5 (VOUT) | Open or ≈1.2 kΩ on separate probe placements; stable while held |

The user now reports polarity-dependent readings between the LDO input and
output nets. This is consistent with semiconductor paths in the unpowered
circuit; it does not identify a fixed 570 Ω resistor or a particular internal
diode. The user clarifies that the reverse result changes only on re-probing:
each placement reads either open or approximately 1.2 kΩ, and the reading holds
while the probes remain in place. This is not a fluctuating reading under held
contact. The reason for the difference between placements has not been isolated;
the observation does not establish charging or meter-range changes.

Polarity dependence provides a plausible explanation for the earlier 570 Ω
P2-to-U1 pin 5 reading versus the open P2-to-U2 pin 8 reading, despite the
below-1 Ω connection between U1 pin 5 and U2 pin 8. The earlier probe polarity
was not recorded, and a matched-polarity repeat using U2 pin 8 has not been
reported, so retain both original observations. The direct low-resistance
connections still establish P2-to-U1 VIN and U1 VOUT-to-EEPROM VCC.

Subsequent regulator-enable results are recorded below.

### Shared regulator input and traced outputs

User reports MP2155 pin 5 to P2 **<1 Ω**, and MP2155 pin 1 to radio pin 6
**<1 Ω**. Assuming the candidate MP2155 identification, P2 feeds both regulator
inputs, U1 VOUT connects to EEPROM VCC, and MP2155 VOUT connects to radio VCC.

```mermaid
flowchart LR
    P2["Connector P2"] -->|"less than 1 Ω"| U1["U1 LDO: VIN 1 + EN 3 → VOUT 5"]
    P2 -->|"less than 1 Ω"| DC["Candidate MP2155: VIN 5 + EN 6 → VOUT 1"]
    U1 -->|"less than 1 Ω"| EE["U2 EEPROM VCC: pin 8"]
    EE ---|"less than 1 Ω"| PU["Shared R29/R32 mode pull-up junction"]
    DC -->|"less than 1 Ω"| RF["Radio VCC: pin 6"]
```

The external links represent measured low-resistance connections; the regulator
blocks identify their input/output functions, not continuity through each IC.
Both EN pins also trace to P2, as detailed below. Actual powered voltages and
any upstream P2 switching remain unmeasured.

### Enable wiring and P3 polarity check (2026-11-13)

| Connection / probe polarity | Reported result |
| --- | --- |
| Candidate MP2155 pin 6 (EN) to P2 | <1 Ω |
| P2 to U1 pin 3 (EN) | <1 Ω |
| P3 to regulator EN pins and radio M0/M1 | No direct connection reported; individual resistance values not supplied |
| Red on P1, black on P3 | ≈1 kΩ |
| Red on P3, black on P1 | Open |
| Diode mode: red P1, black P3 (assumed from “P#”) | 0.97 V |
| Diode mode: red P3 (same assumption), black P1 | Open / OL |

Both regulator EN pins join P2 alongside their VIN pins. This supports the
interpretation that both stages enable when P2 is powered, rather than receiving
separate direct enable signals from P3. Powered sequencing, input voltage and
upstream switching of P2 remain unmeasured. No direct P3-to-EN or P3-to-M0/M1
connection was found; this does not exclude indirect control through other parts.

The P3 reading is polarity-dependent and supports a semiconductor-path hypothesis.
The user suggests a MOSFET body diode. That is possible, but a ground-to-signal
ESD clamp can give the same conduction polarity; the resistance reading alone
identifies neither a MOSFET nor a fixed 1 kΩ resistor. General references:
[Toshiba on MOSFET body diodes](https://toshiba.semicon-storage.com/eu/semiconductor/knowledge/faq/mosfet/i-heard-that-mosfets-have-a-diode-between-drain-and-sourcewhat-k.html)
and [TI on ground clamp diodes](https://www.ti.com/document-viewer/lit/html/SSZTCN0/GUID-540DB5B6-45A1-40EF-A3C7-A07EB772C47F).
These explain candidate mechanisms, not identification of parts on this board.

The subsequent diode-mode report is 0.97 V with red on P1 and black on the
contact written as “P#”, and open in reverse. “P#” is interpreted as P3 from
the immediately preceding test; that interpretation has not been separately
confirmed. The result supports a diode-like path but does not identify a
particular junction or establish a MOSFET body diode.

Next unpowered check: trace P3 to terminals of the paired KN devices and nearby
protection parts without assuming their pinouts. Record any low-resistance
connection and which physical terminal it reaches.

### Q1/Q2 adjacent-resistor traces (2026-11-13)

Orientation for these observations: **pogo pins are up**. The user calls the
two devices Q1 and Q2; “lower-right” is a physical terminal position in this
orientation, not an assigned semiconductor pin number.

| From | To | Reported resistance |
| --- | --- | --- |
| Q1 lower-right terminal | Near end of its adjacent resistor | <1 Ω |
| Other end of Q1-adjacent resistor | P1 (GND) | <1 Ω |
| Q2 lower-right terminal | Near end of its adjacent resistor | <1 Ω |
| Other end of Q2-adjacent resistor | P1 (GND) | <1 Ω |

Each lower-right terminal has a path through its adjacent resistor to ground.
The two below-1 Ω trace segments are not a below-1 Ω terminal-to-ground reading.
The user's follow-up gives the resistor measurements below, using the same
pogo-pins-up orientation. Both left-side resistors connect to their respective
device's lone left terminal; the far ends of those resistors remain untraced.
No numerical continuity reading was supplied for these left-side connections.

| Resistor position | Reported in-circuit resistance |
| --- | --- |
| Right side, upper | ≈46 kΩ; R31/R34 pair later measured in both directions |
| Right side, lower | ≈46 kΩ; R31/R34 pair later measured in both directions |
| Left side, lower | Clarified: ≈4 kΩ with red on shared middle; ≈7.4 kΩ reversed |
| Left side, upper | Clarified: ≈4 kΩ with red on shared middle; ≈7.4 kΩ reversed |

The right-side values are recorded as approximately 46 kΩ each from the plural
report. The later user identification assigns upper to Q2 and lower to Q1,
with pogo pins up.
Printed markings and isolated component values were not supplied; parallel
board circuitry can affect these in-circuit readings. Gate/source/drain
assignments, exact device models and any P3 connection remain unestablished.

Follow-up on the opposite ends of the left-side resistors (the ends away from
the lone transistor terminals):

| From | To | Resistance mode | Continuity mode |
| --- | --- | --- | --- |
| Upper left resistor, opposite end | P3 | ≈2.2 MΩ | Open |
| Lower left resistor, opposite end | P3 | ≈2.2 MΩ | Open |

Both entries follow the user's plural report; probe polarity was not supplied.
The finite high-resistance reading and the open continuity indication are
consistent and show no direct continuity at these points. Do not record this
as a discrete 2.2 MΩ resistor or infer that all indirect P3 paths are excluded.
The destinations of these resistor ends remain unknown.

Upper-right terminal checks, with pogo pins up (2026-11-13):

| Red probe | Black probe | Reported resistance |
| --- | --- | --- |
| Q1 upper-right terminal | P3 | ≈19 kΩ |
| Q2 upper-right terminal | P3 | ≈19 kΩ |
| P3 | Q1 upper-right terminal | Several MΩ, slowly decreasing |
| P3 | Q2 upper-right terminal | Several MΩ, slowly decreasing |

No settled reverse value or observation duration was supplied. These readings
do not establish direct continuity to P3 or a discrete 19 kΩ resistor. Polarity
and time dependence are consistent with indirect semiconductor/charge-dependent
paths, but the mechanism has not been isolated. Similar readings at both
terminals do not establish that the terminals share a net.

Next unpowered check: Q1 upper-right to Q2 upper-right directly. If below 1 Ω,
trace that shared node to known rails (U1 pin 5 / EEPROM VCC, radio pin 6 VCC,
and P2). Keep gate/source/drain unassigned until the terminal mapping is verified.

### Radio UART-to-connector resistance (2026-11-13)

| Radio endpoint | Connector contact | Reported resistance |
| --- | --- | --- |
| Radio pin 3 (RXD) | P12 (tablet TX) | ≈22 Ω |
| Radio pin 4 (TXD) | P11 (tablet RX) | ≈22 Ω |

The user corrected the initial pogo-contact count: radio pin 3 connects to P12,
not P11, and explicitly confirmed radio pin 4 connects to P11. The intermediate
P4 mention was withdrawn. The corrected readings match the earlier powered
ESP32 bench identification of tablet P11 RX and P12 TX; the reported RX/TX
pairing discrepancy is resolved.

The measured paths are consistent with series resistance. Individual components
and reverse-probe readings have not been supplied; these measurements alone do
not establish a particular discrete 22 Ω resistor, complete UART conditioning
circuit, or powered operation of the radio.

### P3 I²C hypothesis (2026-11-13)

The user proposes that P3 may be I²C-related. The carrier's identification
EEPROM provides a concrete tracing target, but P3 has not been assigned to
SDA, SCL or another EEPROM signal. Its diode-like ground path does not identify
a bus function; no I²C traffic has been decoded on P3.

The user subsequently reports no direct connection from P3 to either EEPROM
I²C pin: U2 pin 5 (SDA) or pin 6 (SCL). Numerical resistance, meter mode and
probe polarity were not supplied. P3 remains unassigned; no direct SDA/SCL
connection was found, while indirect circuitry remains untraced.

### EEPROM I²C connector mapping (2026-11-13)

| EEPROM endpoint | Connector contact | Reported resistance |
| --- | --- | --- |
| U2 pin 5 (SDA) | P7 | ≈22 Ω |
| U2 pin 6 (SCL) | P9 | ≈22 Ω |

These user measurements identify P7 as the EEPROM SDA path and P9 as SCL.
The earlier approximately 3.3 V readings on these contacts are compatible with
idle I²C levels; they must not be treated as identified supply outputs. Pull-up
locations/values and powered bus traffic remain unmeasured. The approximately
22 Ω paths are consistent with series resistance, but individual components
and reverse-probe results have not been reported. P3 remains unassigned.

### Radio AUX-to-P3 check (2026-11-13)

| Red probe | Black probe | Reported resistance |
| --- | --- | --- |
| Radio pin 5 (AUX) | P3 | ≈50 kΩ |
| P3 | Radio pin 5 (AUX) | MΩ range; exact value not supplied |

The polarity-dependent, high-resistance readings do not establish a direct
AUX-to-P3 connection or identify a discrete 50 kΩ resistor. Settling behaviour
was not reported. P3's function and AUX's connector routing remain unknown;
an indirect path has not been ruled out.

Next unpowered check: keep one probe on radio pin 5 (AUX) and check the
remaining unassigned contacts P4, P6, P8 and P10 individually for a low-resistance
path. Record actual resistance rather than inferring a connection from a beep.

### Radio M0-to-ground check (2026-11-13)

| Red probe | Black probe | Reported resistance |
| --- | --- | --- |
| P5 (board ground) | Radio pin 1 (M0) | ≈10 kΩ |
| Radio pin 1 (M0) | P5 (board ground) | ≈7.5 kΩ |

P5 previously measured below 1 Ω to U2 ground in both directions, so these
readings characterize an M0-to-ground path. They establish neither direct
continuity nor a discrete 10 kΩ/7.5 kΩ pull-down. The polarity dependence
requires treating them as in-circuit readings; settling behaviour was not supplied.
The resemblance to the earlier 7.4 kΩ lower-left resistor reading does not
establish that this is the same path.

Next unpowered check: M0 to the lone left terminal of each Q1/Q2, with pogo
pins up, looking for low-resistance continuity. This tests whether either
paired device connects to radio mode control without assigning transistor pins.

### Radio M1-to-ground check (2026-11-13)

| Red probe | Black probe | Reported resistance |
| --- | --- | --- |
| P5 (board ground) | Radio pin 2 (M1) | ≈3.8 kΩ |
| Radio pin 2 (M1) | P5 (board ground) | ≈7.5 kΩ |

The compact report “black on M1->P53.8k, reversed 7.5” is interpreted as
P5 / 3.8 kΩ, with the reversed value in kΩ as in the preceding M0 measurement.
These are in-circuit readings, not direct continuity or identified resistor
values. Settling behaviour was not supplied. Similarity to the earlier
approximately 4 kΩ upper-left resistor reading is a tracing lead, not proof
of a connection.

The subsequent M1-to-upper-device lone-left check is recorded below. Later
direct-continuity results identify M1 with the lower device and M0 with the
upper device, as recorded in the mode-pin mapping section.

### M1 to upper device lone-left terminal (2026-11-13)

Orientation remains pogo pins up. “Upper” names the physical device position;
it was subsequently identified by the user as Q2 (lower device: Q1).

| Red probe | Black probe | Reported resistance |
| --- | --- | --- |
| Radio pin 2 (M1) | Upper device, lone-left terminal | ≈19.3 kΩ |
| Upper device, lone-left terminal | Radio pin 2 (M1) | ≈19.5 kΩ |

The close readings in both polarities do not establish direct continuity or
a specific discrete resistor. No settling or measurement-tolerance information
was supplied. The earlier resemblance between M1-to-ground and upper-left
resistor readings has not yielded a direct M1-to-lone-left connection.

Next unpowered checks: M1 to the upper device's upper-right terminal, then
its lower-right terminal, retaining physical position labels.

### Upper-left resistor endpoints clarified (2026-11-13)

With pogo pins up, label the upper-left resistor ends **A** (directly connected
to the upper device's lone-left terminal) and **B** (the opposite end). These
are local tracing labels, not transistor pin numbers.

| Measurement | Reported result |
| --- | --- |
| Resistor end A to upper device lone-left terminal | Direct connection reported; numerical resistance not restated |
| M1 to end A | ≈19 kΩ in clarification; earlier terminal readings 19.3/19.5 kΩ by polarity |
| M1 to end B | ≈4 kΩ; probe polarity not supplied |
| Across resistor A–B | ≈4 kΩ; user confirms this is the resistor reading |

The clarification does not report a below-1 Ω M1 connection to either end.
Keep the three resistance measurements separate: they do not support a simple
M1-to-terminal series-resistor model by arithmetic. Readings were taken in
circuit, and common polarity, settling conditions and contact repeatability
across all three measurements have not been established. No additional resistor
value or gate/source/drain assignment is inferred.

The later R29/R32 junction trace below identifies the shared resistor ends
with U2 VCC, resolving the supply-side junction.

### Radio mode pins mapped to paired devices (2026-11-13)

Orientation: **pogo pins up**. The user explicitly identifies **upper = Q2**
and **lower = Q1**. Gate/source/drain identities remain unassigned.

| Radio endpoint | Device terminal | Reported resistance |
| --- | --- | --- |
| Radio pin 1 (M0) | Upper Q2, lone-left terminal | <1 Ω; red M0, black Q2 terminal |
| Radio pin 2 (M1) | Lower Q1, lone-left terminal | <1 Ω; red M1, black Q1 terminal |

These direct-continuity measurements connect the paired KN devices to the
radio's mode signals. They do not yet establish how the devices are driven,
which semiconductor terminals these are, or any P3-to-mode control path.
The latest user checks explicitly place red on the radio mode pin and black
on the named Q terminal, confirming both the continuity and Q1/Q2 assignments.
Reverse-polarity repeats were not reported for these below-1 Ω checks.

The user identifies the shared middle junction as the connection between
**R29 and R32** and corrects “U8” to **U2 pin 8** for the following measurement.

| From | To | Reported resistance |
| --- | --- | --- |
| Shared R29/R32 middle junction | P1 (ground) | ≈330 Ω |
| U2 pin 8 (EEPROM VCC) | Shared R29/R32 middle junction | <1 Ω |

The 330 Ω value supersedes the initial 300 Ω report. The below-1 Ω connection
places the shared junction on **U1 VOUT / EEPROM VCC**. Thus 330 Ω is an
in-circuit rail-to-ground reading, not a discrete grounding resistor. Probe
polarity and settling behaviour were not supplied.

Together with the outer-end connections to the lone-left terminals and the
M0/M1 continuity results, this identifies **R29/R32 as mode-pin pull-ups** to
the LDO output rail. The user explicitly confirms that interpretation. U1 is
the nominal 3.3 V variant by marking; actual powered rail voltage remains
unmeasured. Which individual reference designator corresponds to upper versus
lower has not been separately recorded.

The user clarifies that **both R29/R32 have the same polarity-dependent
in-circuit readings**:

| Resistors tested | Red probe | Black probe | Reported resistance |
| --- | --- | --- | --- |
| Both R29 and R32 | Shared middle junction (U1 output / U2 VCC) | Respective outer, mode-pin end | ≈4 kΩ each |
| Both R29 and R32 | Respective outer, mode-pin end | Shared middle junction | ≈7.4 kΩ each |

This supersedes the earlier apparent upper/lower value difference: it was a
probe-polarity distinction in the reported readings, not evidence of different
resistor values. These remain in-circuit measurements affected by the surrounding
circuit; nominal resistor values and markings have not been established.

The known mode-node wiring is shown below; the transistor boxes identify only
measured terminal connections, not verified gate/source/drain assignments.

```mermaid
flowchart TB
    V["U1 pin 5 / U2 pin 8: common supply rail"] --- J["Shared R29/R32 junction"]
    J --- RU["Upper pull-up: nominal value unconfirmed"]
    J --- RL["Lower pull-up: nominal value unconfirmed"]
    RU --- M0["Radio pin 1: M0"]
    RL --- M1["Radio pin 2: M1"]
    M0 --- QU["Upper Q2: lone-left terminal"]
    M1 --- QL["Lower Q1: lone-left terminal"]
```

The paired devices may provide a way to pull the mode signals low, but their
remaining terminal functions and control inputs are still untraced. Next
unpowered checks: each device's upper-right terminal to U2 pin 4 (ground),
then trace the lower-right terminals toward connector contacts. No P3 control
assignment is established.

### Paired-device resistor junctions and P4/P6 paths (2026-11-13)

Orientation remains pogo pins up. The user supplies these component designators
and measurements:

| Component | Reported in-circuit resistance |
| --- | --- |
| R31 | ≈46 kΩ in both probe directions |
| R34 | ≈46 kΩ in both probe directions |
| R30 (rotated 90° relative to adjacent R31) | ≈1 kΩ in both probe directions |
| R33 (rotated 90° relative to adjacent R34) | ≈1 kΩ in both probe directions |

The lower end of each R31/R34 connects to its corresponding Q1/Q2 terminal and
to the corresponding 1 kΩ resistor. This extends the earlier lower-right-terminal
trace: the user now explicitly confirms the other ends of **R31 and R34**
each connect to **P1 at below 1 Ω**. Thus these are approximately 46 kΩ
pull-down branches on the respective Q/1 kΩ resistor junctions; the Q terminal
functions remain unassigned. Probe polarities for the ground-continuity checks
were not supplied. The final
parenthetical “1k resistor (R31/34)” is interpreted as R30/R33, consistent with
the component values explicitly given in the same report. Pair association
R31/R30 and R34/R33 follows the user's corresponding-pair description.

| Connection | Reported result |
| --- | --- |
| P4 to one end of R30 | <1 Ω |
| P6 to R33 | Connection reported; exact resistance and end not specified |
| R31 end opposite the Q/R30 junction | P1 ground: <1 Ω |
| R34 end opposite the Q/R33 junction | P1 ground: <1 Ω |

These identify P4 and P6 as candidate control inputs through the 1 kΩ
resistors to the paired mode-connected devices. The endpoints selected for the
connector checks were not explicitly identified relative to the transistor-side
junctions, so the complete series paths still need endpoint confirmation.
Do not record R33-to-P6 as below 1 Ω without a numerical reading.

Next unpowered checks: P4 to its corresponding Q lower-right terminal and P6
to its corresponding Q lower-right terminal. Approximately 1 kΩ would support
placement of R30/R33 in series. Record whether each is the upper (M0-connected)
or lower (M1-connected) device, then check the upper-right terminals to ground.
The transistor terminal identities, P4/P6-to-M0/M1 assignment and switching
polarity remain unverified; P3 remains unassigned.

### Radio AUX-to-P10 check (2026-11-13)

| Red probe | Black probe | Reported resistance |
| --- | --- | --- |
| P10 | Radio pin 5 (AUX) | ≈37 kΩ |
| Radio pin 5 (AUX) | P10 | ≈40 kΩ |

“blan on AUX” is interpreted as “black on AUX” from context. These in-circuit
readings do not establish direct continuity or a discrete 37–40 kΩ resistor.
Settling behaviour was not supplied. P10 remains unassigned, and AUX still has
no identified direct pogo connection. An indirect path has not been ruled out.

Follow-up: the user reports **radio pin 5 (AUX) to P8: open**. Probe polarity
and meter mode were not specified; do not treat this as a confirmed both-polarity
result. P8 remains unassigned.

No direct AUX path has been established on P3, P8 or P10. These checks do not
prove that AUX is unconnected everywhere on the carrier or exclude indirect
circuitry. No new pogo assignment follows from this result.

### Radio AUX-to-P3 repeat check (2026-11-13)

The user explicitly confirmed that “P#” in this repeat measurement means P3.

| Red probe | Black probe | Reported resistance |
| --- | --- | --- |
| Radio pin 5 (AUX) | P3 | ≈49 kΩ |
| P3 | Radio pin 5 (AUX) | Megaohms; exact value unspecified |

This agrees with the earlier ≈50 kΩ / megaohm reading. It does not establish
direct continuity or identify the intervening circuit; P3 remains unassigned.

### FPC connector height and retaining plate (2026-11-13)

User measurements: housing thickness **2.27 mm**; total uncompressed pogo-tip
to solder-top height **5.60 mm** (corrected from 5.25 mm); fully compressed
tip-to-solder-top height **4.60 mm**. The difference gives **1.00 mm travel**.
These total heights do not independently establish housing-rim-to-solder offset
or tablet contact recess depth.

The FPC exits **left** when mounted correctly, looking at the tablet back in
our standard orientation. IMG20261111202302 shows the solder side with the flex
extending right; that photographed orientation is not the mounted orientation.
The [P1-based retaining plate](../cad/fpc-retainer/README.md) includes an open
solder window, left flex relief and adjustable spacer stacks. Its nominal
0.30 mm compression now uses the user-reported **approximately 1 mm contact
recess** and an unverified zero solder-to-rim offset. R2 lowers the nominal
spacer stack from 4.0 to **3.0 mm** (2.60 mm spacer + 0.40 mm shim), placing the
retaining plane at **4.30 mm above the mounting surface**. The plate geometry
is unchanged; only spacers and assembly height change. Physical compression
and fit remain to be checked. The earlier zero-recess R1 height is superseded.

### Supplied screws and retainer R3 (2026-11-13)

The user reports supplied radio-module screws specified as **M2×8.5**, maximum
threading depth approximately **2 mm**, and requests **1.5 mm engagement**. The
user confirms the nominal screw length excludes the head; it is the supplied
specification, not a physical length measurement. R3 derives plate thickness from screw length, target
engagement and spacer height: **8.5 - 1.5 - 3.0 = 4.0 mm**. With 3.0 mm nominal
spacers, the 7.0 mm screw path leaves 1.5 mm engagement and nominal 0.5 mm bottom
clearance. The retaining plane remains 4.30 mm above the mounting surface;
added plate material is on the outward side. R2 spacers remain usable with R3.
Actual thread depth, any cap strap/washer stack and printed dimensions still
need checking during assembly.
