rambo/dmdt-865_expansion/android/T865UartTx/VALIDATION.md

# Validation — 2026-11-07

- `assembleDebug lintDebug`: PASS with JDK 17.0.21, Gradle 8.13, AGP 8.13.2, Kotlin 2.2.21, SDK 36, NDK 27.2.12479018, CMake 3.22.1. arm64-v8a and x86_64 compile with `-Wall -Wextra -Werror`.
- Lint: 0 errors, 17 warnings (pinned Gradle version, backup metadata, English-only UI text). Full report retained; no issue suppressed.
- Native ASan/UBSan test: PASS. Actual pseudo-terminal verifies exact bytes, 9600/8N1/raw/no flow control, descriptor flags, missing/non-character/non-TTY errors, duplicate-open rejection, bounded write timeout, close-once behavior and requested termios restoration. macOS returns ENODEV for `/dev/null`, and may add the transient PENDIN flag when canonical mode returns; the check handles those host differences.
- Debug APK: v2 signature and 16 KiB ZIP alignment verified. No requested permissions. A 16 KiB-page runtime was not tested.
- Installed on the physical Android 16 T865, ordinary app UID 10204, with production SELinux policy. Native open/configure and repeated full 20-byte writes succeeded without root or expansion ioctls.
- ADB normal Stop succeeded, no frames continued after Stop, and Start resumed. Final build was reinstalled after normal Stop. Device UI and filtered app logcat are retained.
- Scope: pin 12 / CH4 decoded eight exact copies of `UUUU T865 UART WK2\r\n`, 160 bytes, 9600/8N1 noninverted, zero framing errors. Ground pin 1. Separate raw capture and decoder are retained in T865PortProbe/analysis/uart-wk2-pins3-4-7-12-2026-11-07/.

No UART RX, external module compatibility, voltage tolerance, cold-boot power sequencing, other UARTs, or Meshtastic traffic was tested. That initial session transmitted in the foreground for live probing; current state is recorded below. Scope identification relies on the user's stated physical pad placement.

## Version 1.1: UART idle hold

Actual `assembleDebug lintDebug` PASS. Added ADB `--ez idle true`: cancels periodic writes and keeps WK2 open/configured, or opens it without sending if initially stopped. Start resumes using that open session; Stop restores/closes as before. Native code is unchanged.

Installed on the tablet after normal Stop. UI and logcat show UART IDLE, with no TX frames from the new process. ADB `run-as` descriptor readback confirms fd 111 points to `/dev/ttysWK2`. It remains open in the foreground, with no repeating writes, for the user's multimeter measurement. Active-TX-to-idle cancellation was not exercised on hardware in this update, to avoid sending new frames during the requested idle measurement. Existing source closes the session on leaving the foreground.

User reports CH4 Vmax 3.44 V on pin 7. The scope is now in Auto sweep for current DC levels. The user then measured pin 12 at 2.5 V against pin 1 and 2.464 V against a cradle GND pad. These are user-reported meter readings, not remotely acquired samples. The approximately 36 mV difference may reflect ground offset or measurement variation; the UART bridge supply itself remains unmeasured. All-external-power keep-awake remains 15.

### Additional user-reported DC measurements (UART held idle)

All relative to pin 1 unless specified:

| Backside pad | Meter reading | Interpretation |
| --- | --- | --- |
| 1 | Reference | Ground reference for these readings |
| 2 | Initially 2.5 V, falling | Unknown; final voltage/rate not supplied |
| 3 | 0 mV | Known software-controlled pulse pad, currently low |
| 4 | 1.79 V | Unknown |
| 5 | 1.5 V | Unknown |
| 6 | 36 mV | Unknown; does not establish GND |
| 7 | 3.3 V | Supply/high-level candidate; function unconfirmed |
| 8 | 1 mV | Ground unconfirmed |
| 9 | 3.3 V | Supply candidate; function unconfirmed |
| 10 | 39 mV | Low level; does not establish GND |
| 11 | 2.49 V | RX candidate beside confirmed TX; DC alone cannot establish direction/function |
| 12 | 2.5 V | Confirmed WK2 TX held idle; 2.464 V relative to cradle GND |

The low pin-10 reading differs from the earlier scope's ~0.24 V. These were separate measurements with remapped probes; do not infer a hardware-state change without verifying contacts and references. No RX injection, loopback, UART write or expansion command was performed for these measurements. The bridge supply voltage remains unmeasured.

Pin 2's falling level could reflect a weakly biased/un-driven node or stored charge; the cause and final value are unverified. These are sequential readings. Near-zero voltage does not establish ground; pin 3 provides a known counterexample. No new UART write or expansion command was sent. Full map: [EXPANSION-PIN-MAP-2026-11-07.md](../../docs/reports/EXPANSION-PIN-MAP-2026-11-07.md).

## Version 1.2: receive-only monitoring for external RX identification

- Actual `assembleDebug lintDebug` PASS; lint 0 errors, 21 warnings (English-only UI strings and existing metadata/version warnings).
- Native ASan/UBSan PTY test PASS including exact injected RX bytes, empty nonblocking reads and the existing TX/configuration/timeout/restoration checks.
- Installed after normal Stop; receive-only Idle opens WK2 and polls available bytes without transmitting. Device UI/logcat and one-descriptor readback retained. Normal Stop cancels RX and restores/closes; reopening Idle succeeds without RX errors. A Home-key attempt did not produce a verified background transition, so receiver cancellation was checked with explicit ADB Stop instead.
- APK v2 signature and 16 KiB ZIP alignment verified. Native code compiled for both supported ABIs with warnings treated as errors.
- Receiver is left active at 9600/8N1 with TX idle. No external-MCU RX signal or loopback has been injected. Host PTY reception is not proof of a physical tablet RX pin. See [RX-PROBE-WIRING.md](RX-PROBE-WIRING.md); the resistor circuit is a proposed bench setup, not an electrically tested assembly.

## Follow-up: external ESP32 link verified both directions

ESP32UartProbe was compiled/uploaded for a PICO-D4, TX GPIO26 / RX GPIO25 at 9600/8N1. Android received the exact numbered ESP32 strings. User confirms GPIO26 connects to tablet pin 11: WK2 RX is now electrically identified. After GPIO25 was connected to tablet pin 12, a brief tablet TX test delivered five exact tablet frames (100 bytes) to the ESP32. Tablet TX was restored to idle. Evidence is in ../ESP32UartProbe/validation/ and [UART-END-TO-END-2026-11-07.md](../../docs/reports/UART-END-TO-END-2026-11-07.md). Initial preparation limitations above describe the earlier state; voltage margins and cold-boot behavior remain unverified.
