rambo/dmdt-865_expansion/firmware/ESP32UartProbe/validation/smoke-result.txt

PASS: sequential 24-byte frames near 1 Hz, pause suppresses TX, resume restarts TX
