rambo/dmdt-865_expansion/android/T865UartTx/validation/native-test.txt

PASS: real PTY bytes, raw 9600/8N1, errors, timeout, and termios restoration
