rambo/dmdt-865_expansion/android/T865UartTx/validation/rx-native-test.txt

PASS: real PTY TX/RX bytes, empty nonblocking RX, raw 9600/8N1, errors, timeout, termios restoration
