rambo/dmdt-865_expansion/measurements/initial-app-validation/emulator-dialog.png

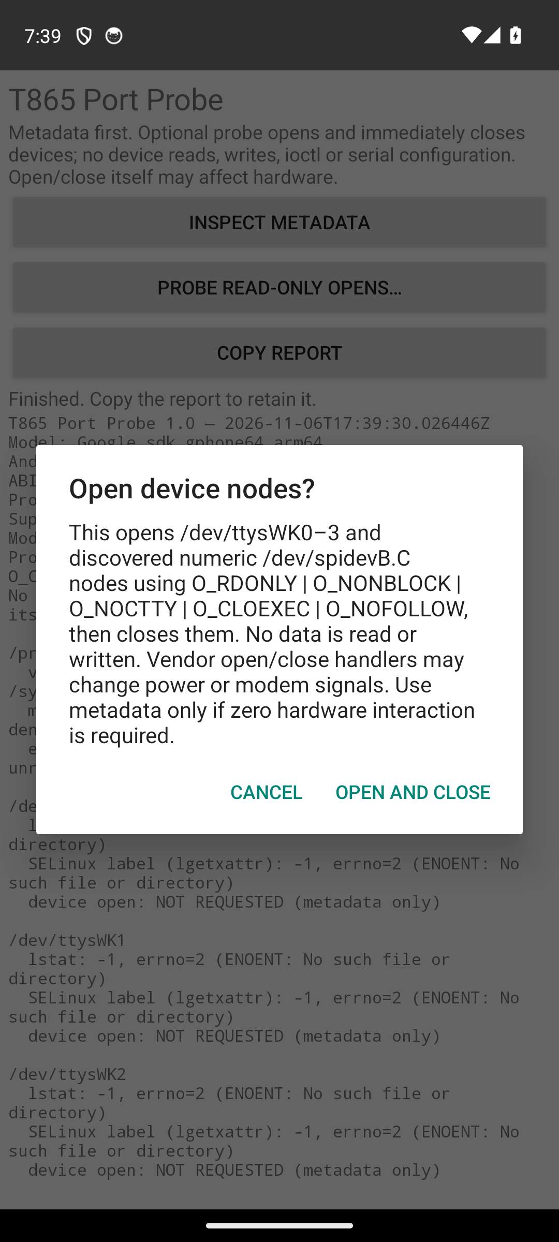
measurements/initial-app-validation/emulator-dialog.png
