rambo/dmdt-865_expansion/measurements/photos/expansion-adapter-2026-11-11/previews/IMG20261111204318.jpg

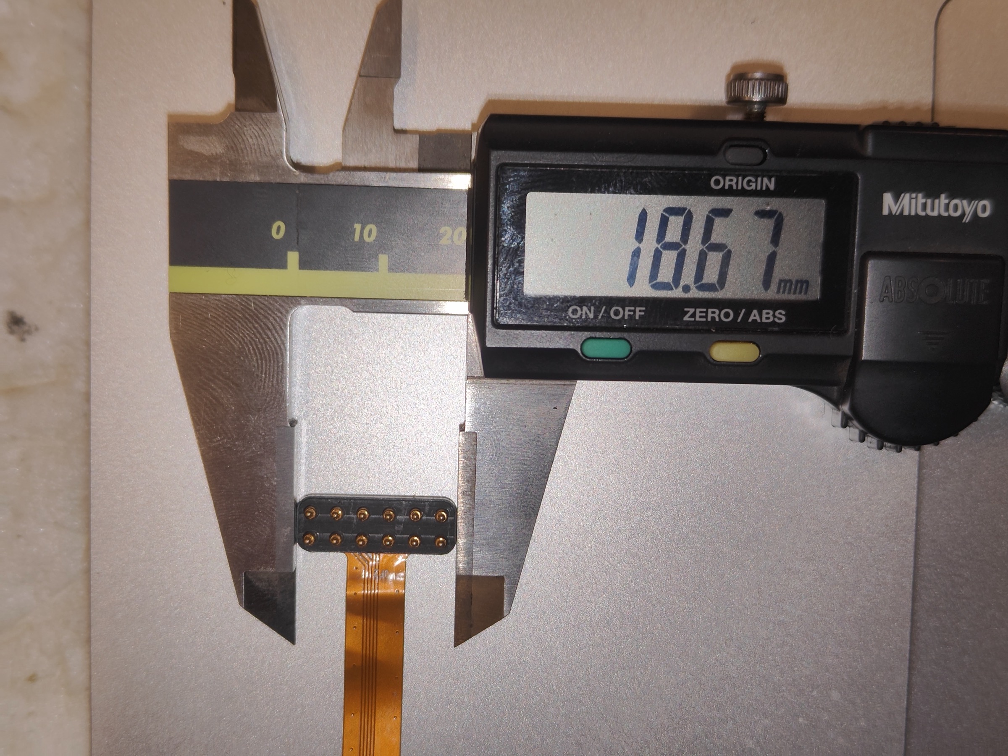
measurements/photos/expansion-adapter-2026-11-11/previews/IMG20261111204318.jpg
