rambo/dmdt-865_expansion/measurements/photos/lora-teardown-2026-11-11/previews/IMG20261111195358.jpg

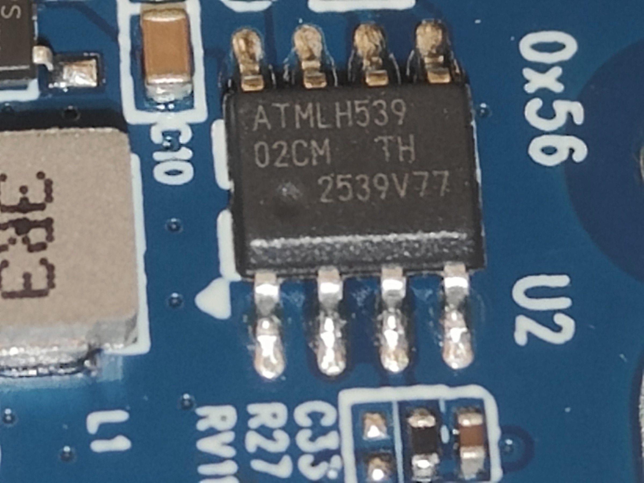
measurements/photos/lora-teardown-2026-11-11/previews/IMG20261111195358.jpg
