rambo/dmdt-865_expansion/measurements/post-update-discovery/cycle2-enabled-screen.png

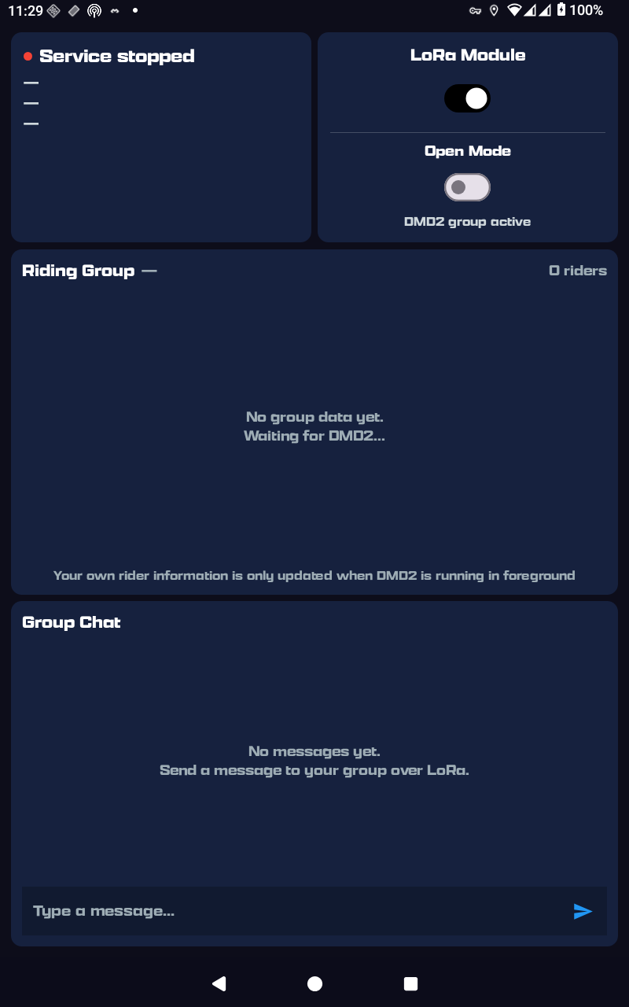
measurements/post-update-discovery/cycle2-enabled-screen.png
