rambo/dmdt-865_expansion/measurements/post-update-discovery/manage-screen.png

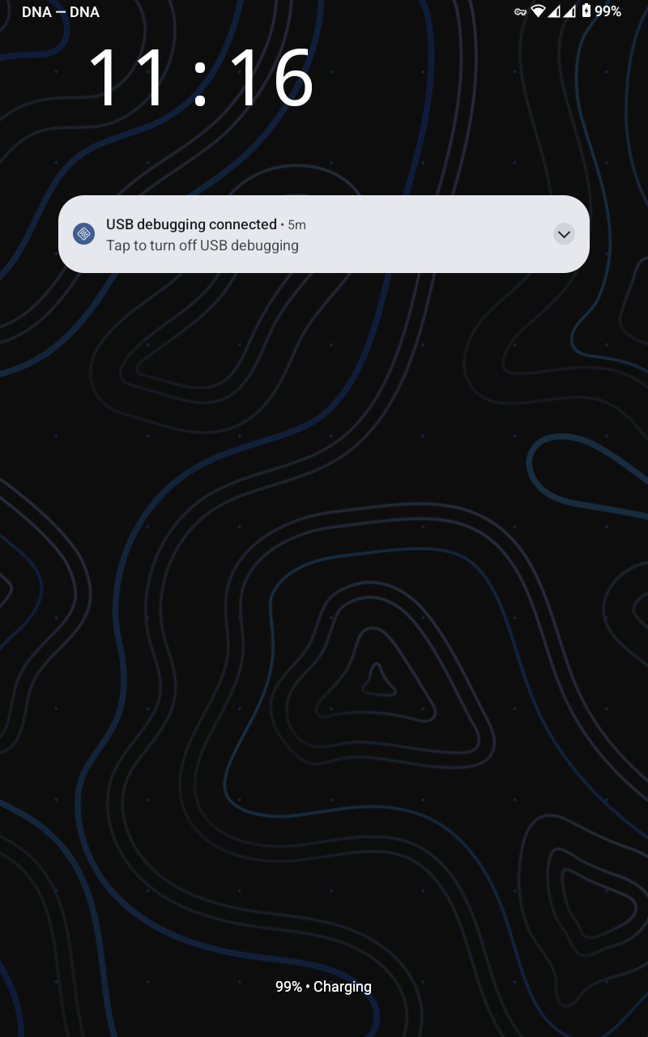
measurements/post-update-discovery/manage-screen.png
