rambo/dmdt-865_expansion/measurements/scope-workspace/remapped-cycle-2026-11-07/enabled-screen.png

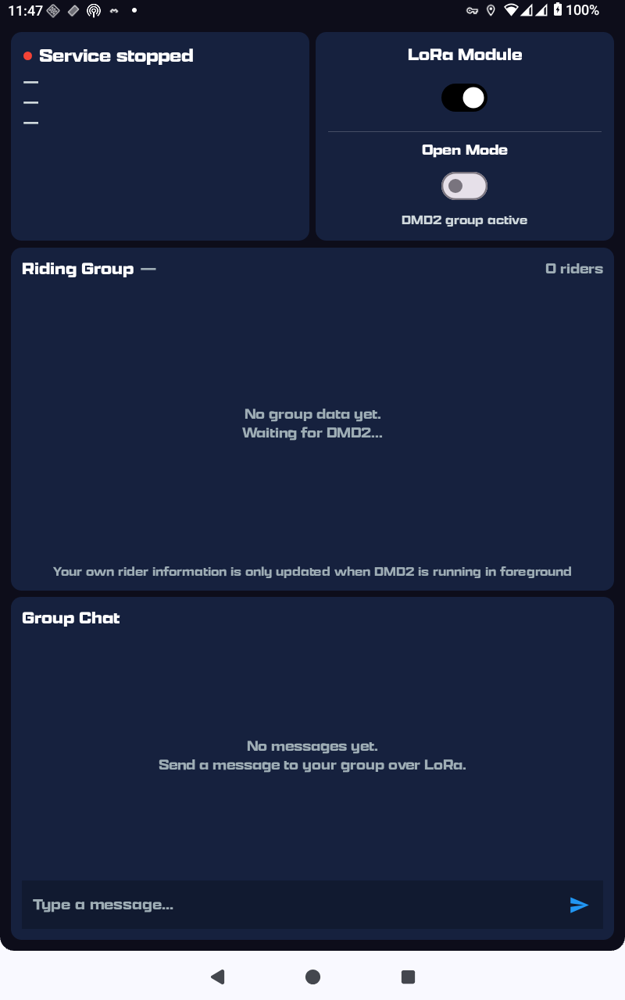
measurements/scope-workspace/remapped-cycle-2026-11-07/enabled-screen.png
