rambo/dmdt-865_expansion/docs/history-lfs-map.csv

19314a25aa7710b033d9dd0a18b72d719592611a | f5edd451d9fb8c5aefdf981619cc93104854d755
dc95b3d4f482db910f7b6c7b6c1b761da9fd1b63 | e0e2f3eb0f83e48a25c4be600d5a1d3ab3ff6534
4653b6deee3808f69d1dd5cd61a05ffcab706e94 | 5c6743ed2b7414ecfad210d0b7a84b31d535ae35
1923729a742d9a001c2a4ae2804c7df54f5c1199 | f5b9df72a9aa7d3f83f9068b4b74bce562ceec25
5f7de56ac5f663561ff3de476f363eeab7354379 | c9b8c33212731b409ea30b2d12093368eeedbdd4
e6dbdec094a70324e1670bec6db29ef0f4e9356f | d92cd36ce6662f4fa747185c4811698843612e81
4088ebdad5bd06ba79ccdaa3a3ce454b39a7a0b1 | 2b3d29b19bb679022d5a6c8b491bbba2d18611e3
849a67abf93e16e969fd90c49791a0fa04fe17d4 | 334ae4db116b32f4f5bb70743a6c6808ea2f3dd6
c5f098a31f695c08ae49e84b1f1d5fc5b8e59ef8 | 547053b8d5c72e7f1880f20365f33c3fe187395b
2329838a9034eb6b8c417ad965451d0e9f658dfc | d98880a87c54bdf4b584959d6527dc48c77435d4
0d773dee0b79044e554897533673756cfd99714e | 20ce358ab6b4197fa879193bfc46743005adddcd
b93b61b397a55d90368de1dd7ed3e631fe1e6f67 | 4be1e80d406e2c895880c1dc85f99ce3d1f6c05d
1ed5f75092ffea7c7f37e0d6d3f6f5fbc44e0883 | 9d21698b0da836d73c3a67fe43bd22e03483970c
82118cc01a3b3fdf3b3b574dba2856e34e056dfb | c718fe053484b69eaa01e9f5cd7c84a0ad1075ce
561728c1157253eb65244ff8eae40353794f9803 | c74926e79976106faad354a370485e123609039c
b1c73f264aa212b4125672e5ed839cee0fed293b | b4bc7c68bc5c9c85489673873bef492d9cbf3a34
249f74aaeb4d80fb05d605c02d10e206d0bbee37 | 8510e4fe307707be606ae5918b899b6bb3d82c76
b6094028925d90b228833c03ef076490689886d8 | 132d12cd38958a886e448d443538ca76cfadd1b6
f66fef17e0d904a262ab3dc6f06263b718c9935e | 58f608998ad1f37a4c9e8148c96e6f8a053f6cf7
a9a43736c8d5c9c3af129d78848301ffec076211 | 6a0fc6a3f3da12a53ad4932565a8084b25f1553a
5f24af6f8a07bc580061167b5c2fd691d87ee2ec | d556c1eb243b158e479aeb2c71e6cf80a5f2908a
ce6771347c2aaa8fed8391c5e7bc2e3e3e73a1da | 8e5141310f484f69ac1ed3505eef6a7f6dfc395e
653ad01079542e5a72a64460bb0b7b4c7eae5027 | a5dc74fd5241196b4248f3597620eb6771473970
de2f25181d451db1411aed22d95fb26a0eaac133 | db17c710521b2609303ba713c428849d373bb14a
