rambo/dmdt-865_expansion/docs/evidence/gpio-control-api/Factory16-native-arm64.asm

/Users/rambo/Documents/ChatGPT/motorbikestuff/work/gpio-api-trace/libjni_freeme_expand-16.so:	file format elf64-littleaarch64

Disassembly of section .text:

0000000000004000 <.text>:
    4000: d503201f     	nop
    4004: 1001ffe0     	adr	x0, 0x8000
    4008: 140002a6     	b	0x4aa0 <__cxa_finalize@plt>
    400c: 00000000     	udf	#0x0
    4010: d65f03c0     	ret
		...
    4020: 17fffffc     	b	0x4010 <.text+0x10>
		...

0000000000004030 <convert_to_long>:
    4030: f9400000     	ldr	x0, [x0]
    4034: d65f03c0     	ret
		...

0000000000004040 <Java_com_freeme_factory_cradle_ExpandGpio_open>:
    4040: d10143ff     	sub	sp, sp, #0x50
    4044: a9017bfd     	stp	x29, x30, [sp, #0x10]
    4048: f90013f7     	str	x23, [sp, #0x20]
    404c: a90357f6     	stp	x22, x21, [sp, #0x30]
    4050: a9044ff4     	stp	x20, x19, [sp, #0x40]
    4054: 910043fd     	add	x29, sp, #0x10
    4058: d53bd056     	mrs	x22, TPIDR_EL0
    405c: aa0203f4     	mov	x20, x2
    4060: f94016c8     	ldr	x8, [x22, #0x28]
    4064: 910013e2     	add	x2, sp, #0x4
    4068: aa1403e1     	mov	x1, x20
    406c: aa0003f3     	mov	x19, x0
    4070: f90007e8     	str	x8, [sp, #0x8]
    4074: f9400008     	ldr	x8, [x0]
    4078: 390013ff     	strb	wzr, [sp, #0x4]
    407c: f942a508     	ldr	x8, [x8, #0x548]
    4080: d63f0100     	blr	x8
    4084: 52800041     	mov	w1, #0x2                // =2
    4088: aa0003f5     	mov	x21, x0
    408c: 9400029d     	bl	0x4b00 <__open_2@plt>
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
    4b18: 91090210     	add	x16, x16, #0x240
    4b1c: d61f0220     	br	x17

0000000000004b20 <__stack_chk_fail@plt>:
    4b20: 90000030     	adrp	x16, 0x8000
    4b24: f9412611     	ldr	x17, [x16, #0x248]
    4b28: 91092210     	add	x16, x16, #0x248
    4b2c: d61f0220     	br	x17
