rambo/dmdt-865_expansion/measurements/driver-discovery/freeme-expand-arm64.asm

work/expand-driver/libjni_freeme_expand.so:	file format elf64-littleaarch64

Disassembly of section .text:

0000000000001000 <.text>:
    1000: d503201f     	nop
    1004: 10007fe0     	adr	x0, 0x2000
    1008: 140002aa     	b	0x1ab0 <__cxa_finalize@plt>
    100c: 00000000     	udf	#0x0
    1010: d65f03c0     	ret
		...
    1020: 17fffffc     	b	0x1010 <.text+0x10>
		...

0000000000001030 <convert_to_long>:
    1030: f9400000     	ldr	x0, [x0]
    1034: d65f03c0     	ret
		...

0000000000001040 <Java_com_freeme_factory_cradle_ExpandGpio_open>:
    1040: d10143ff     	sub	sp, sp, #0x50
    1044: a9017bfd     	stp	x29, x30, [sp, #0x10]
    1048: f90013f7     	str	x23, [sp, #0x20]
    104c: a90357f6     	stp	x22, x21, [sp, #0x30]
    1050: a9044ff4     	stp	x20, x19, [sp, #0x40]
    1054: 910043fd     	add	x29, sp, #0x10
    1058: d53bd056     	mrs	x22, TPIDR_EL0
    105c: aa0203f4     	mov	x20, x2
    1060: f94016c8     	ldr	x8, [x22, #0x28]
    1064: 910013e2     	add	x2, sp, #0x4
    1068: aa1403e1     	mov	x1, x20
    106c: aa0003f3     	mov	x19, x0
    1070: f90007e8     	str	x8, [sp, #0x8]
    1074: f9400008     	ldr	x8, [x0]
    1078: 390013ff     	strb	wzr, [sp, #0x4]
    107c: f942a508     	ldr	x8, [x8, #0x548]
    1080: d63f0100     	blr	x8
    1084: 52800041     	mov	w1, #0x2                // =2
    1088: aa0003f5     	mov	x21, x0
    108c: 9400028d     	bl	0x1ac0 <__open_2@plt>
    1090: b0000017     	adrp	x23, 0x2000
    1094: 2a0003e3     	mov	w3, w0
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
    1b28: 91090210     	add	x16, x16, #0x240
    1b2c: d61f0220     	br	x17

0000000000001b30 <__memcpy_chk@plt>:
    1b30: b0000010     	adrp	x16, 0x2000
    1b34: f9412611     	ldr	x17, [x16, #0x248]
    1b38: 91092210     	add	x16, x16, #0x248
    1b3c: d61f0220     	br	x17
