rambo/dmdt-865_expansion/(commit log)

2026-11-06 feat: add read-only Android port probe
2026-11-06 feat: probe explicit SPI targets and exclude SPI-UART
2026-11-06 docs: hand off expansion pin and power investigation
2026-11-06 docs: clarify single expansion bay with two pin columns
2026-11-06 docs: record E220 FCC photo search and connector evidence
2026-11-06 docs: distinguish direct E220 UART control from RF chip access
2026-11-06 docs: identify built-in expand driver and factory EEPROM interface
2026-11-07 docs: record scope pin mapping and pause for firmware update
2026-11-07 docs: clarify pin 8 reference and record remapped probes
2026-11-07 docs: confirm WK2 TX on pin 12 with decoded UART frames
2026-11-07 feat: add WK2 UART transmitter with verified pin 12 output
2026-11-07 docs: record UART idle hold for multimeter measurement
2026-11-07 docs: record pin 12 idle voltage against both grounds
2026-11-07 docs: record multimeter confirmation of 2.5V TX idle
2026-11-07 docs: record idle measurements and pin 11 RX candidate
2026-11-07 docs: record idle voltages on expansion pads 9 to 11
2026-11-07 docs: record full idle pad voltages and pin 2 decay
2026-11-07 docs: complete user measured expansion pad voltage map
2026-11-07 docs: prepare current limited ESP32 probe for WK2 RX
2026-11-07 feat: add and validate PICO-D4 UART probe on GPIO26 and GPIO25
2026-11-07 docs: confirm expansion RX pin 11 and bidirectional WK2 link
2026-11-07 docs: record external MCU confirmation of both UART directions
2026-11-07 refactor: place fit-check CAD in its own directory
2026-11-07 fix: enlarge contact inspection holes and label fit gauges R2
2026-11-07 docs: trace expansion GPIO API and factory indices
2026-11-13 docs: record ground readings and U1 pin orientation
2026-11-13 docs: record U1 ground continuity
2026-11-13 docs: record radio connector ground resistance survey
2026-11-13 docs: clarify ground reference and P5 bidirectional continuity
2026-11-13 docs: trace P2 to LDO input and record radio VCC label
2026-11-13 docs: clarify stable readings across probe placements
2026-11-13 docs: record shared P2 regulator input
2026-11-13 docs: trace converter output to radio supply
2026-11-13 docs: trace regulator enables to P2 and record P3 diode-like path
2026-11-13 docs: record P3 diode-mode result with probe polarity
2026-11-13 docs: record Q1 Q2 adjacent resistor ground paths
2026-11-13 docs: record paired transistor resistor values and routing
2026-11-13 docs: record high-resistance resistor-to-P3 checks
2026-11-13 docs: record radio UART paths and flag connector label discrepancy
2026-11-13 docs: correct radio UART pogo-contact mapping
2026-11-13 docs: add P3 I2C hypothesis and EEPROM tracing checks
2026-11-13 docs: record no direct P3 connection to EEPROM I2C
2026-11-13 docs: record M0 ground resistance in both polarities
2026-11-13 docs: record M1 ground resistance in both polarities
2026-11-13 docs: record M1 upper transistor terminal resistance
2026-11-13 docs: clarify upper resistor endpoints and M1 readings
2026-11-13 docs: record corrected shared-junction ground resistance
2026-11-13 docs: clarify matching pull-up readings by probe polarity
2026-11-13 docs: trace P4 P6 to paired-device resistor networks
2026-11-13 docs: confirm R31 R34 pull-down ground connections
2026-11-13 docs: record AUX to P10 resistance checks
2026-11-13 feat(cad): add adjustable T865 FPC connector retainer
2026-11-13 fix(cad): account for recessed tablet contacts in FPC mount
2026-11-13 fix(cad): size FPC retainer for supplied 8.5 mm screws
2026-11-13 docs: confirm supplied M2x8.5 screw specification
